rocbuilder/folding-trolley/20 design intent.txt

TO DESIGN A STORAGE SYSTEM, WHICH CAN BE COMPRESSED INTO A SMALLER SPACE WHEN NOT IN USE
