rocbuilder/folding-trolley/05 product specification.docx

Product specification

Characteristics:

Size reduction

Shelving that can be height adjusted

Lockable caster wheels for mobility

Specifications:

size (height, depth, length):

when expanded 165x60x120cm

when compressed 165x36x120cm

~40% size reduction
