rocbuilder/folding-trolley/01 product leaflet.pptx

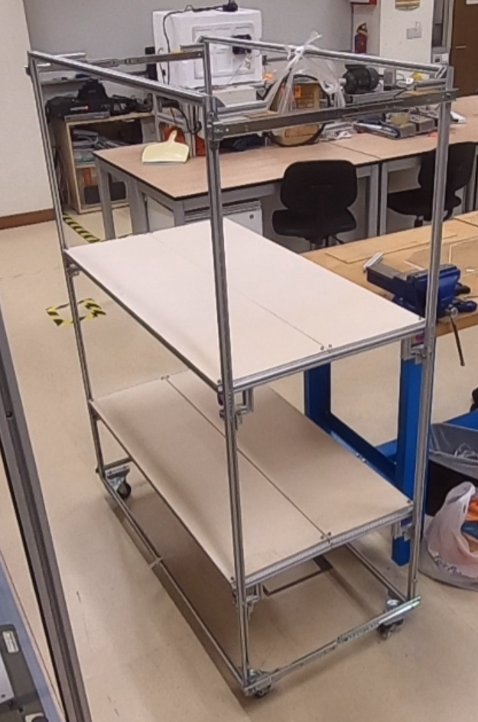
[picture p1: figure]
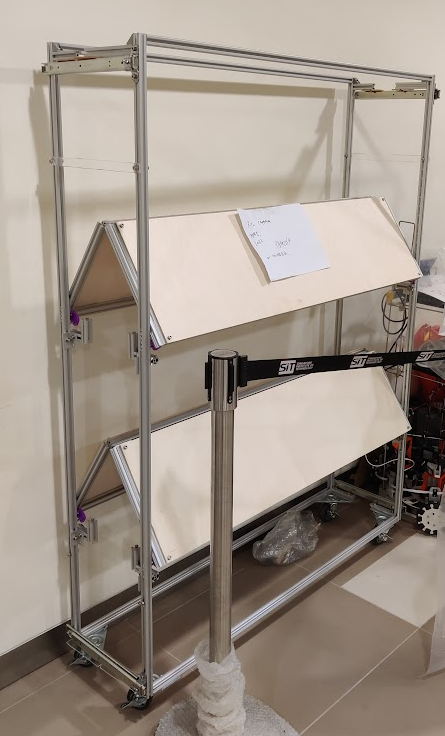
[picture p2: figure]

The collapsible cart

Features:
- Able to become 40% smaller
- On caster wheels
- Adjustable shelf heights
