rocbuilder/folding-trolley/03 presentation.pptx

## Design of a compressible shelving unit

Chew En Yu, 1901438

## Introduction

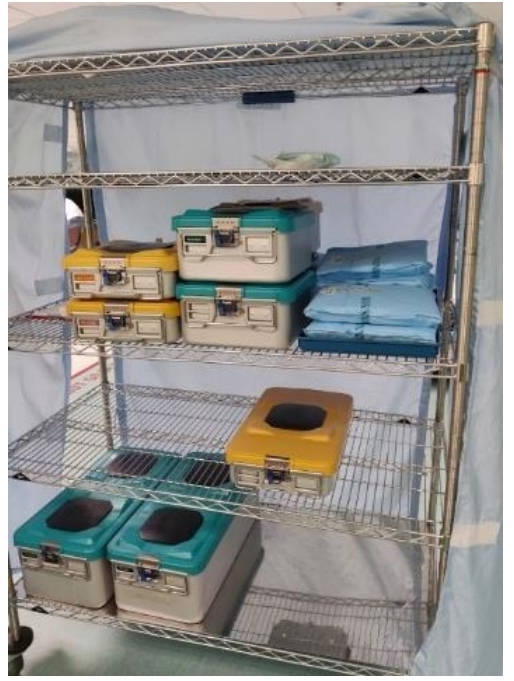
[picture p3: figure]

## Applicable products and mechanisms

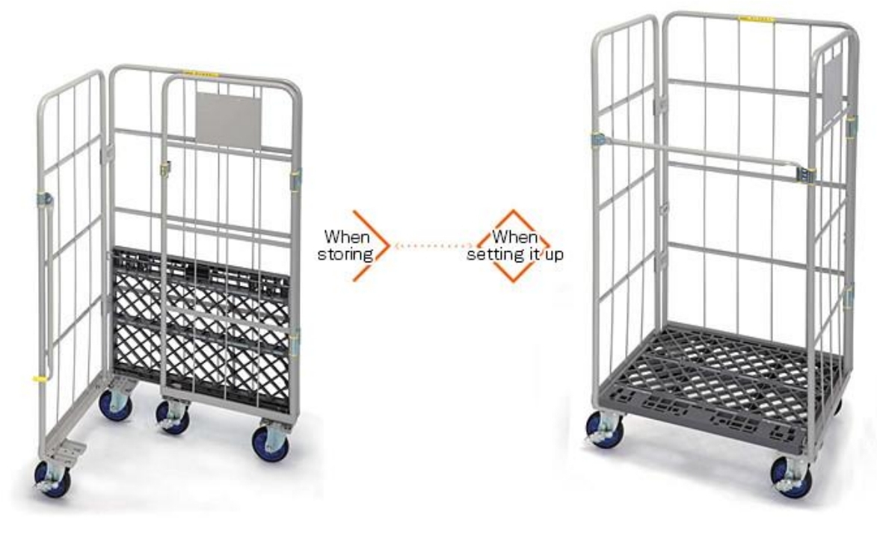
[picture p4: figure]
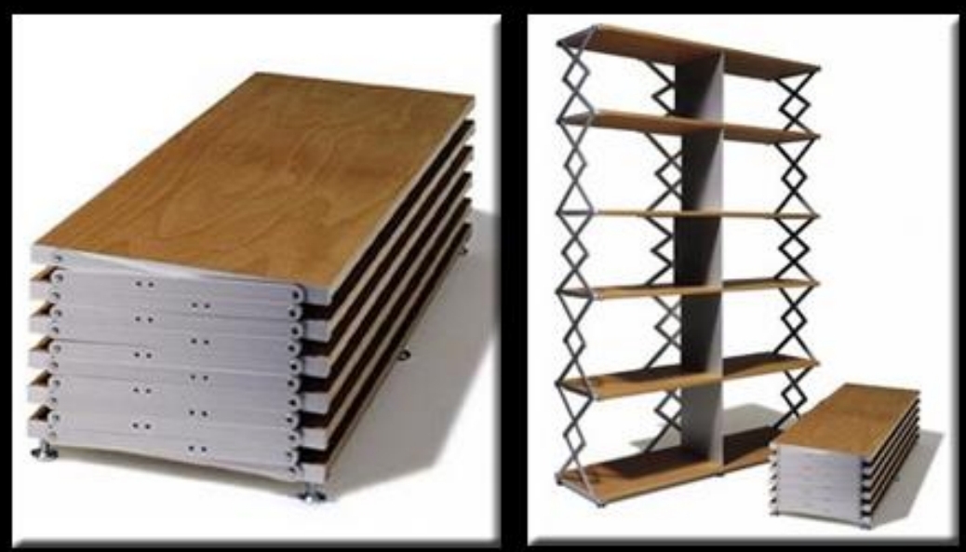
[picture p5: figure]

## Slide 4

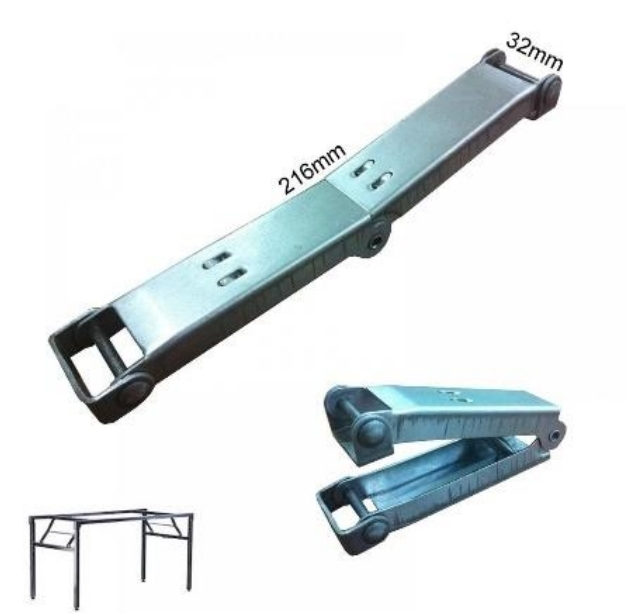
[picture p6: figure]
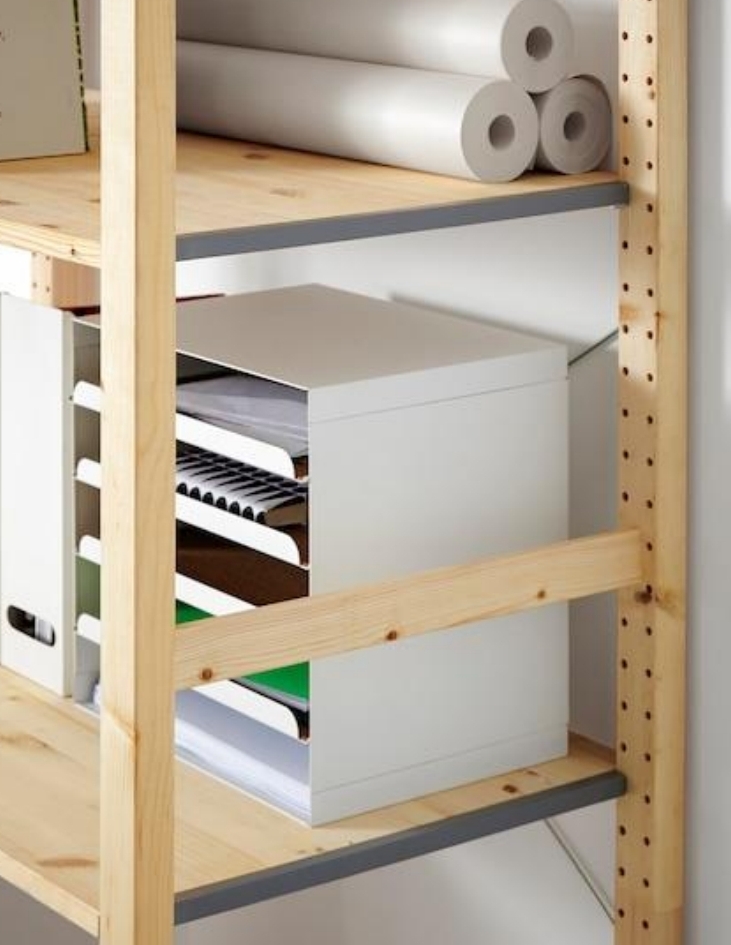
[picture p7: figure]
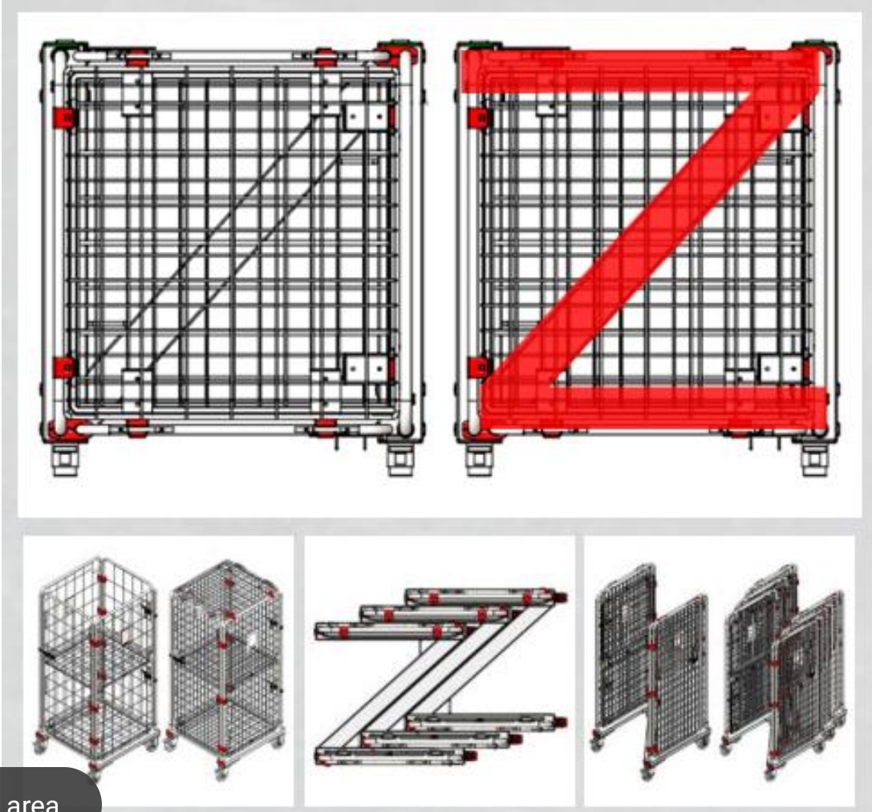
[picture p8: figure]

## Inspiration

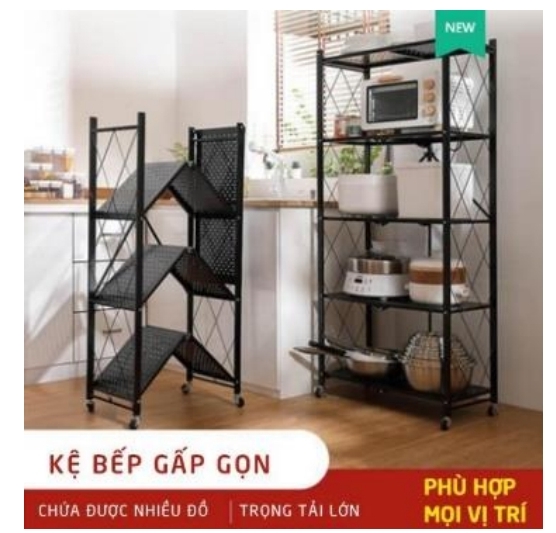
[picture p9: figure]

## Slide 6

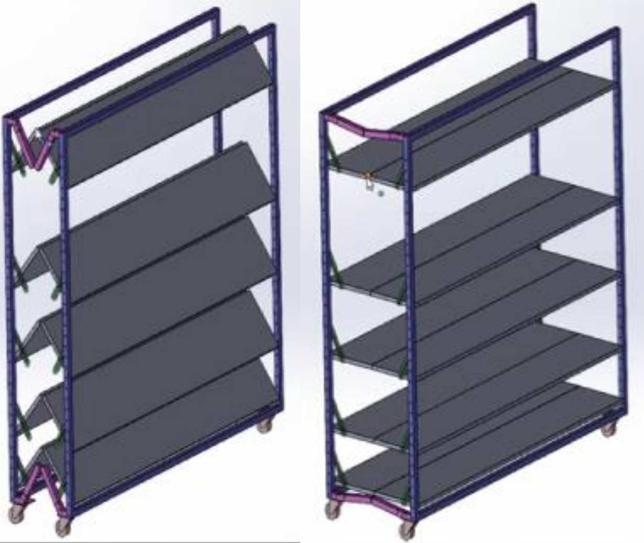
[picture p10: figure]
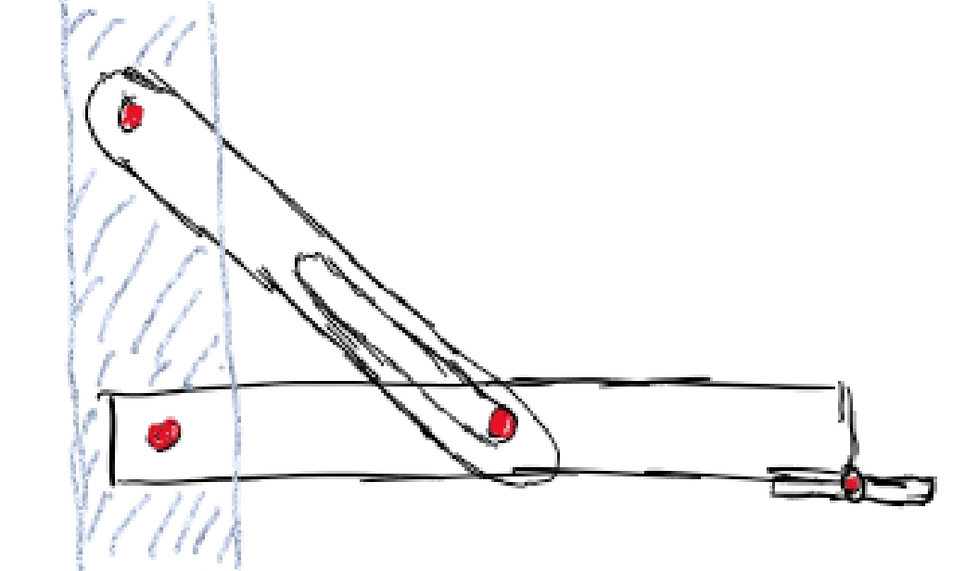
[picture p11: figure]

## Slide 7

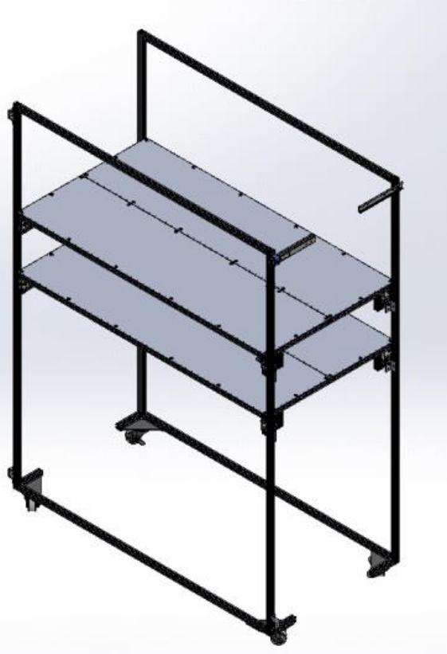
[picture p12: figure]
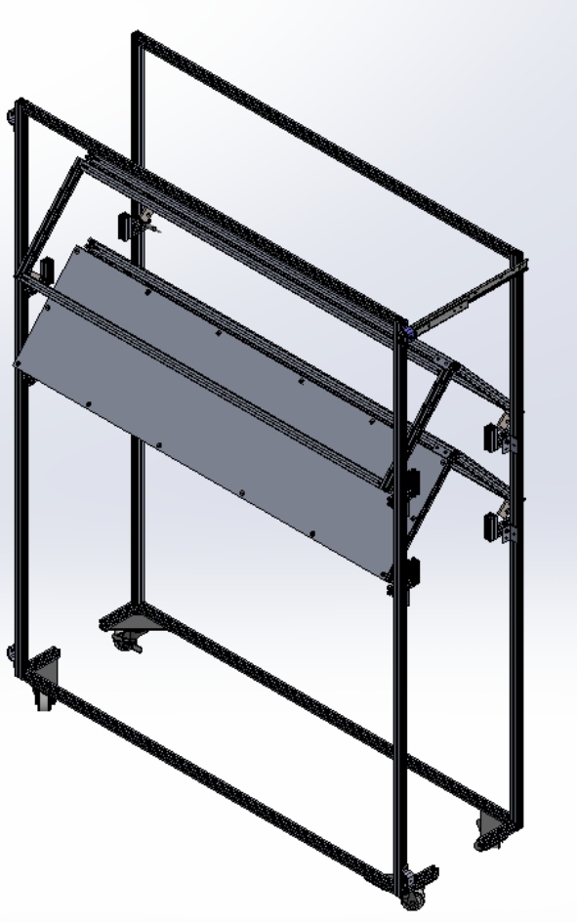
[picture p13: figure]

## Key features

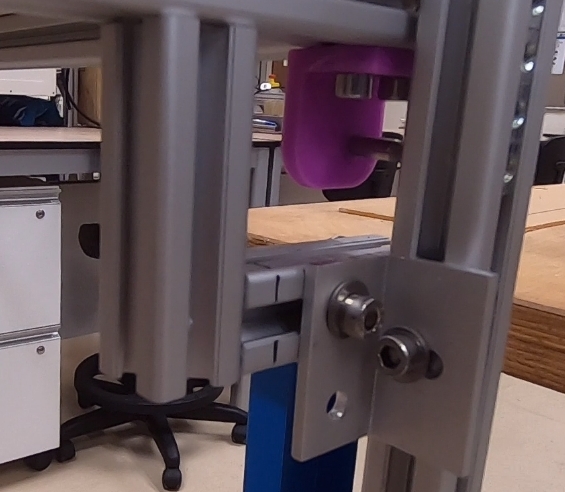
[picture p14: figure]
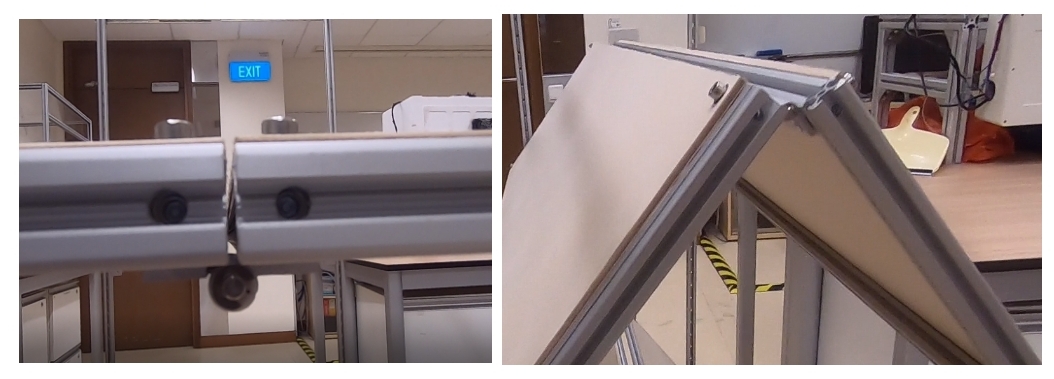
[picture p15: figure]

## Slide 9

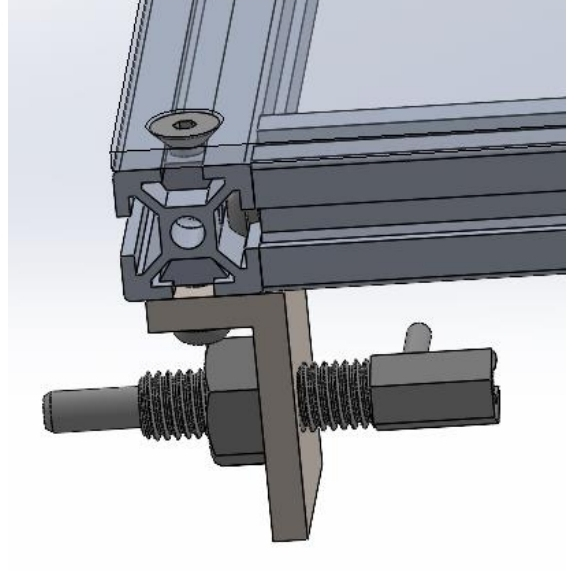
[picture p16: figure]
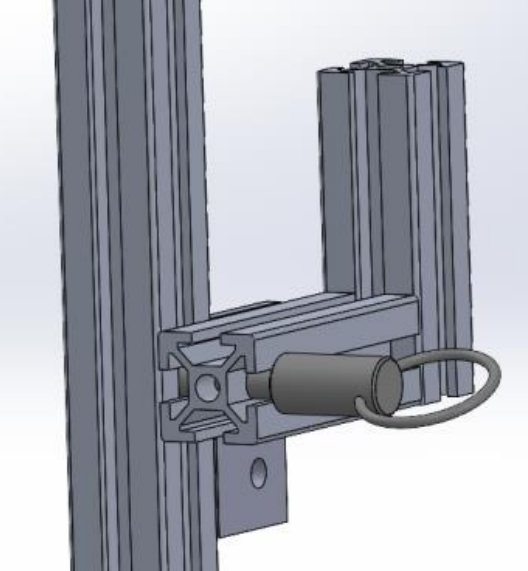
[picture p17: figure]

## Conclusion
