rocbuilder/folding-trolley/16 parts bom.xlsx

Sheet: detailed bom
ITEM NO. | PART NUMBER | DESCRIPTION | QTY. | supplier | supplier part number
1 | Shelf assembly adjustable |  | 2
1.1 | shelf length | 2020 profile, 1118mm, M5x16 tapped on both ends | 2 | prestech | PTP-2020-6
1.2 | shelf depth | 2020 profile, 300mm, wrench holes on both ends | 2 | prestech | PTP-2020-6
1.3 | HHPBSN5 flat 2020 hinge | aluminium 2020 profile hinge | 1 | prestech | PTA-AH2020-6
1.4 | HNTTSN5-5 2020 nut | 2020 profile nut | 22 | prestech | PTC-SBM5/2020
1.5 | SHFBS5-8 | hex socket CS flat head cap screw M5x8 | 18 | prestech | PTC-CS5X 8
1.6 | shelf top | 1158mm x 300mm plate with drilled holes | 1 | plywood online
1.7 | shelf angle bracket right | aluminium bracket | 1 | prestech | PTP-MB2038-5
1.8 | shelf angle bracket left | aluminium bracket | 1 | prestech | PTP-MB2038-5
1.9 | HBCBM5-15 | Hex socket button head cap screw M5x15 | 4 | prestech | PTC-SSBH5X 16
1.10 | lblt6 |  | 2
1.11 | SLBNR10 | M10 nut | 2
1.12 | SBCB5-10 | hex button head cap screw M5x10 | 4 | prestech | PTC-SSBH5X 10
1.13 | SPWF5 | M5 washer | 4
2 | shelf support left |  | 4
2.1 | HBCBM5-15 | Hex socket button head cap screw M5x15 | 1 | prestech | PTC-SSBH5X 16
2.2 | shelf support depth | 2020 profile | 1
2.3 | shelf support height | 2020 profile | 1
2.4 | shelf support bracket | L profile | 1 | prestech | PTP-2525AB-T3
2.5 | HNTTSN5-5 2020 nut | 2020 profile nut | 1 | prestech | PTC-SBM5/2020
2.6 | SCB5-8 | socket head cap screw M5x8 | 1 | prestech | PTC-SSSH5X 8
2.7 | SPWF5 | M5 washer | 1
3 | shelf support right |  | 4
3.1 | HBCBM5-15 | Hex socket button head cap screw M5x15 | 1 | prestech | PTC-SSBH5X 16
3.2 | shelf support depth | 2020 profile | 1
3.3 | shelf support height | 2020 profile | 1
3.4 | shelf support bracket | L profile | 1 | prestech | PTP-2525AB-T3
3.5 | HNTTSN5-5 2020 nut | 2020 profile nut | 1 | prestech | PTC-SBM5/2020
3.6 | SCB5-8 | socket head cap screw M5x8 | 1 | prestech | PTC-SSSH5X 8
3.7 | SPWF5 | M5 washer | 1
4 | SPWF5 | M5 washer | 6
5 | HNTTSN5-5 2020 nut | 2020 profile nut | 6 | prestech | PTC-SBM5/2020
6 | BLPS6-30 |  | 2
7 | SCB5-40 | hex button head cap screw M5x40 | 6 | prestech | PTC-SSSH5X 40
8 | shelf assembly fixed |  | 2
8.1 | shelf length | 2020 profile, 1118mm, M5x16 tapped on both ends | 2 | prestech | PTP-2020-6
8.2 | shelf depth | 2020 profile, 300mm, wrench holes on both ends | 2 | prestech | PTP-2020-6
8.3 | HHPBSN5 flat 2020 hinge | aluminium 2020 profile hinge | 1 | prestech | PTA-AH2020-6
8.4 | HNTTSN5-5 2020 nut | 2020 profile nut | 22 | prestech | PTC-SBM5/2020
8.5 | SHFBS5-8 | hex socket CS flat head cap screw M5x8 | 18 | prestech | PTC-CS5X 8
8.6 | shelf top | 1158mm x 300mm plate with drilled holes | 1 | plywood online
8.7 | shelf angle bracket right fixed | aluminium bracket | 1 | prestech | PTP-MB2038-5
8.8 | shelf angle bracket left fixed | aluminium bracket | 1 | prestech | PTP-MB2038-5
8.9 | HBCBM5-15 | Hex socket button head cap screw M5x15 | 4 | prestech | PTC-SSBH5X 16
8.10 | SCB6-45 | socket head cap screw M6x45 | 2 | prestech | PTC-SSSH6X 45
8.11 | SPWF6 | M6 washer | 2
8.12 | SLBNR6 | M6 nut | 2 | prestech | PTC-HNM6
8.13 | SBCB5-10 | hex button head cap screw M5x10 | 4 | prestech | PTC-SSBH5X 10
8.14 | SPWF5 | M5 washer | 4
9 | shelf extension mechanism |  | 4
9.1 | HBCBM5-10 | Hex socket button head cap screw M5x10 | 2 | prestech | PTC-SSBH5X 10
9.2 | SPWF5 | M5 washer | 2
9.3 | IBNP4-8 | hex button head cap screw M4x8 | 1 | prestech | PTC-SSBH4X 8
9.4 | SPWF4 | M4 washer | 1
9.5 | SLBNR4 | M4 nut | 1 | prestech | PTC-HNM4
9.6 | FBL27D+200L (MIN) |  | 1 | Monotaro | FBL27D+300
9.6.1 | _FBL27D+200 Drawer rail | Drawer rail part, wrong part number | 1 |  | FBL27D+300
9.6.2 | _FBL27D+200 Retainer | Drawer rail part, wrong part number | 2 |  | FBL27D+300
9.6.3 | _FBL27D+200 Center Rail | Drawer rail part, wrong part number | 2 |  | FBL27D+300
9.7 | _FBL27D+200 Drawer rail | Drawer rail part, wrong part number | 1 |  | FBL27D+300
9.8 | convex bent sheet metal mounting plate | convex sheet metal | 1 | prestech | custom sheet metal part
10 | frame assembly main side |  | 1
10.1 | frame vertical | 2020 profile, 1550mm, wrench hole on bottom end through front and left side, wrench hole on top end on front side, 40x 6OD holes every 30mm from 120mm from bottom on front side | 2 | prestech | PTP-2020-6
10.2 | frame horizontal | 2020 profile, 1160mm, M5x16 tapped on both ends | 2 | prestech | PTP-2020-6
10.3 | frame caster bracket | 2020 profile, 100mm, M5x16 tapped on one end | 2 | prestech | PTP-2020-6
10.4 | HBCBM5-15 | Hex socket button head cap screw M5x15 | 6 | prestech | PTC-SSBH5X 16
10.5 | HSMCS50-N |  | 2 | Monotaro
10.5.1 | _DUMMY-HSMCS50-N | aluminium caster part | 1
10.5.2 | _SWIVEL-HSMCS50 | aluminium caster part | 1
10.5.3 | _BODY-HSMCS50 | aluminium caster part | 1
10.5.4 | _WHEEL-HSMCS50-N | aluminium caster part | 1
10.5.5 | _STOPPER-HSMCS50 | aluminium caster part | 1
10.6 | HNTTSN5-5 2020 nut | 2020 profile nut | 16 | prestech | PTC-SBM5/2020
10.7 | SPWF5 | M5 washer | 8
10.8 | SCB5-10 | socket head cap screw M5x10 | 8 | prestech | PTC-SSSH5X 10
11 | frame assembly slave side |  | 1
11.1 | frame vertical | 2020 profile, 1550mm, wrench hole on bottom end through front and left side, wrench hole on top end on front side, 40x 6OD holes every 30mm from 120mm from bottom on front side | 2 | prestech | PTP-2020-6
11.2 | frame horizontal | 2020 profile, 1160mm, M5x16 tapped on both ends | 2 | prestech | PTP-2020-6
11.3 | frame caster bracket | 2020 profile, 100mm, M5x16 tapped on one end | 2 | prestech | PTP-2020-6
11.4 | HBCBM5-15 | Hex socket button head cap screw M5x15 | 6 | prestech | PTC-SSBH5X 16
11.5 | HSMCS50-N |  | 2 | Monotaro
11.5.1 | _DUMMY-HSMCS50-N | aluminium caster part | 1
11.5.2 | _SWIVEL-HSMCS50 | aluminium caster part | 1
11.5.3 | _BODY-HSMCS50 | aluminium caster part | 1
11.5.4 | _WHEEL-HSMCS50-N | aluminium caster part | 1
11.5.5 | _STOPPER-HSMCS50 | aluminium caster part | 1
11.6 | HNTTSN5-5 2020 nut | 2020 profile nut | 12 | prestech | PTC-SBM5/2020
11.7 | SPWF5 | M5 washer | 8
11.8 | SCB5-10 | socket head cap screw M5x10 | 8 | prestech | PTC-SSSH5X 10

Sheet: parts bom
ITEM NO. | PART NUMBER | DESCRIPTION | supplier | supplier part number | QTY. | ITEM NO. in detailed BOM
1 | frame vertical | 2020 profile, 1550mm, wrench hole on bottom end through front and left side, wrench hole on top end on front side, 40x 6OD holes every 30mm from 120mm from bottom on front side | prestech | PTP-2020-6 | 4 |  |  |  |  | 10.1 |  | 11.1
2 | frame horizontal | 2020 profile, 1160mm, M5x16 tapped on both ends | prestech | PTP-2020-6 | 4 |  |  |  |  | 10.2 |  | 11.2
3 | frame caster bracket | 2020 profile, 100mm, M5x16 tapped on one end | prestech | PTP-2020-6 | 4 |  |  |  |  | 10.3 |  | 11.3
4 | HBCBM5-15 | Hex socket button head cap screw M5x15 | prestech | PTC-SSBH5X 16 | 36 | 1.9 |  | 3.1 | 8.9 | 10.4 |  | 11.4
5 | _DUMMY-HSMCS50-N | aluminium caster part | misumi |  | 4 |  |  |  |  |  |  | 11.5.1
6 | _SWIVEL-HSMCS50 | aluminium caster part | misumi |  | 4 |  |  |  |  |  |  | 11.5.2
7 | _BODY-HSMCS50 | aluminium caster part | misumi |  | 4 |  |  |  |  |  |  | 11.5.3
8 | _WHEEL-HSMCS50-N | aluminium caster part | misumi |  | 4 |  |  |  |  |  |  | 11.5.4
9 | _STOPPER-HSMCS50 | aluminium caster part | misumi |  | 4 |  |  |  |  |  |  | 11.5.5
10 | HNTTSN5-5 2020 nut | 2020 profile nut | prestech | PTC-SBM5/2020 | 130 | 1.4 |  | 3.5 | 8.4 |  | 10.6 | 11.6 | 5
11 | SPWF5 | M5 washer |  |  | 54 | 1.13 |  | 3.7 | 8.14 | 9.2 | 10.7 | 11.7 | 4
12 | SCB5-10 | socket head cap screw M5x10 | prestech | PTC-SSBH5X 10 | 16 |  |  |  |  |  | 10.8 | 11.8
13 | shelf length | 2020 profile, 1118mm, M5x16 tapped on both ends | prestech | PTP-2020-6 | 8 | 1.1 |  |  | 8.1
14 | shelf depth | 2020 profile, 300mm, wrench holes on both ends | prestech | PTP-2020-6 | 8 | 1.2 |  |  | 8.2
15 | HHPBSN5 flat 2020 hinge | aluminium 2020 profile hinge | prestech | PTA-AH2020-6 | 4 | 1.3 |  |  | 8.3
16 | SHFBS5-8 | hex socket CS flat head cap screw M5x8 | prestech | PTC-CS5X 8 | 72 | 1.5 |  |  | 8.5
17 | shelf top | 1158mm x 300mm plate with drilled holes |  |  | 4 | 1.6 |  |  | 8.6
18 | shelf angle bracket right | aluminium bracket | prestech | PTP-MB2038-5 | 2 | 1.7
19 | shelf angle bracket left | aluminium bracket | prestech | PTP-MB2038-5 | 2 | 1.8
20 | lblt6 |  |  |  | 4 | 1.1
21 | SLBNR10 | M10 nut |  |  | 4 | 1.11
22 | SCB6-45 | socket head cap screw M6x45 | prestech | PTC-SSBH6X 45 | 4 |  |  |  | 8.1
23 | SPWF6 | M6 washer |  |  | 4 |  |  |  | 8.11
24 | SLBNR6 | M6 nut | prestech | PTC-HNM6 | 4 |  |  |  | 8.12
25 | SBCB5-10 | hex button head cap screw M5x10 | prestech | PTC-SSBH5X 10 | 16 | 1.12 |  |  | 8.13
26 | shelf support depth | 2020 profile | prestech |  | 8 |  | 2.2 | 3.2
27 | shelf support height | shelf support height | prestech |  | 8 |  | 2.3 | 3.3
28 | shelf support bracket | L profile | prestech | PTP-2525AB-T3 | 8 |  | 2.4 | 3.4
29 | SCB5-8 | socket head cap screw M5x8 | prestech | PTC-SSBH5X 8 | 8 |  | 2.6 | 3.6
30 | convex bent sheet metal mounting plate | convex sheet metal | prestech | custom sheet metal part | 4 |  |  |  |  | 9.8
31 | HBCBM5-10 | Hex socket button head cap screw M5x10 | prestech | PTC-SSBH5X 10 | 8 |  |  |  |  | 9.1
32 | IBNP4-8 | hex button head cap screw M4x8 | prestech | PTC-SSBH4X 8 | 4 |  |  |  |  | 9.3
33 | SPWF4 | M4 washer |  |  | 4 |  |  |  |  | 9.4
34 | SLBNR4 | M4 nut | prestech | PTC-HNM4 | 4 |  |  |  |  | 9.5
35 | _FBL27D+200 Drawer rail | Drawer rail part, wrong part number | misumi | FBL27D+300 | 8 |  |  |  |  | 9.7 | 9.6.1
36 | BLPS6-30 |  |  |  | 2 |  |  |  |  |  |  |  | 6
37 | SCB5-40 | hex button head cap screw M5x40 | KL lane |  | 6 |  |  |  |  |  |  |  | 7
38 | shelf angle bracket right fixed | aluminium bracket | prestech | PTP-MB2038-5 | 2 |  |  |  | 8.7
39 | shelf angle bracket left fixed | aluminium bracket | prestech | PTP-MB2038-5 | 2 |  |  |  | 8.8
40 | _FBL27D+200 Retainer | Drawer rail part, wrong part number | misumi | FBL27D+300 | 8 |  |  |  |  |  | 9.6.2
41 | _FBL27D+200 Center Rail | Drawer rail part, wrong part number | misumi | FBL27D+300 | 8 |  |  |  |  |  | 9.6.3

Sheet: price summary
supplier | Parts | cost (SGD) | remarks | contact
prestech | aluminium profile and profile system | 500.55 | quotation basis | email to sales@prestech.com.sg
plywood online | plywood shelf top | 25 | online purchase; supplier quotes $12.50 for sizes ~0.8m^2 and below. 2x plywood was purchased, then sawn in half to reduce cost | www.Plywood-Online.com
Monotaro | Slide rail FBL27D | 155.96 | online purchase | https://www.monotaro.sg
 | Corner caster SGC series | 47.96
 | total | 729.47
