rocbuilder/folding-trolley/12 original part assembly and drawing/shelf assembly.SLDASM

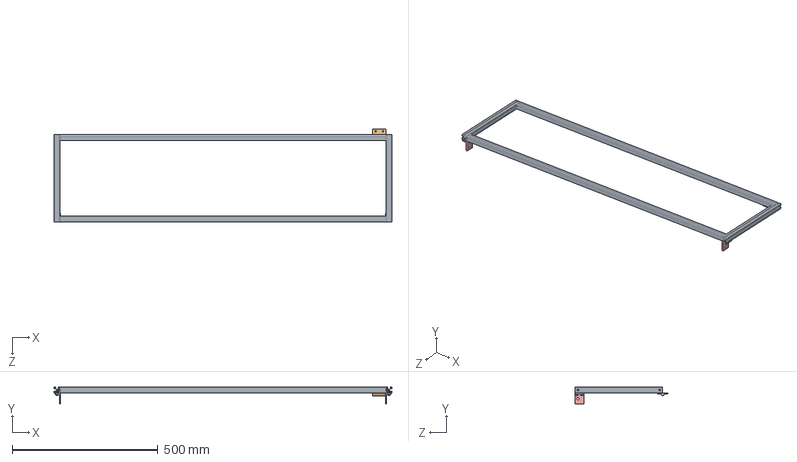
[picture p18: CAD file, 2022-11-20]
12 original part assembly and drawing/shelf assembly.SLDASM
1158.0 x 58.0 x 318.5 mm
HFS Aluminium Frame 2020 x 4
HHPBSN5 flat 2020 hinge
HNTTSN5-5 2020 nut x 8
SHFBS5-8 x 2
shelf mechanism angle bracket x 2
HBCBM5-15 x 4
SBCB5-10 x 4
SPWF5 x 4
