rocbuilder/folding-trolley/12 original part assembly and drawing/full assembly.SLDASM

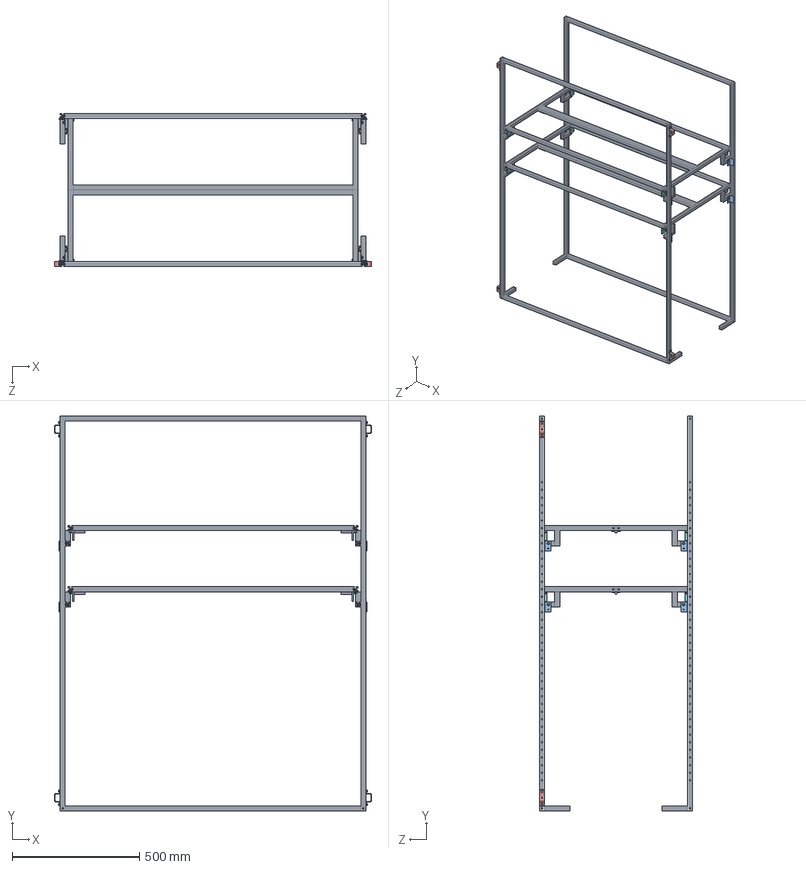
[picture p19: CAD file, 2022-11-20]
12 original part assembly and drawing/full assembly.SLDASM
1244.2 x 1550.0 x 601.0 mm
HFS Aluminium Frame 2020 x 44
HBCBM5-15 x 36
HNTTSN5-5 2020 nut x 56
HBCBM5-10 x 8
convex bent sheet metal mounting plate x 4
HHPBSN5 flat 2020 hinge x 4
SHFBS5-8 x 8
shelf mechanism angle bracket x 8
SBCB5-10 x 16
SPWF5 x 24
shelf support bracket x 8
SCB5-8 x 8
