rocbuilder/folding-trolley/12 original part assembly and drawing/frame assembly.SLDASM

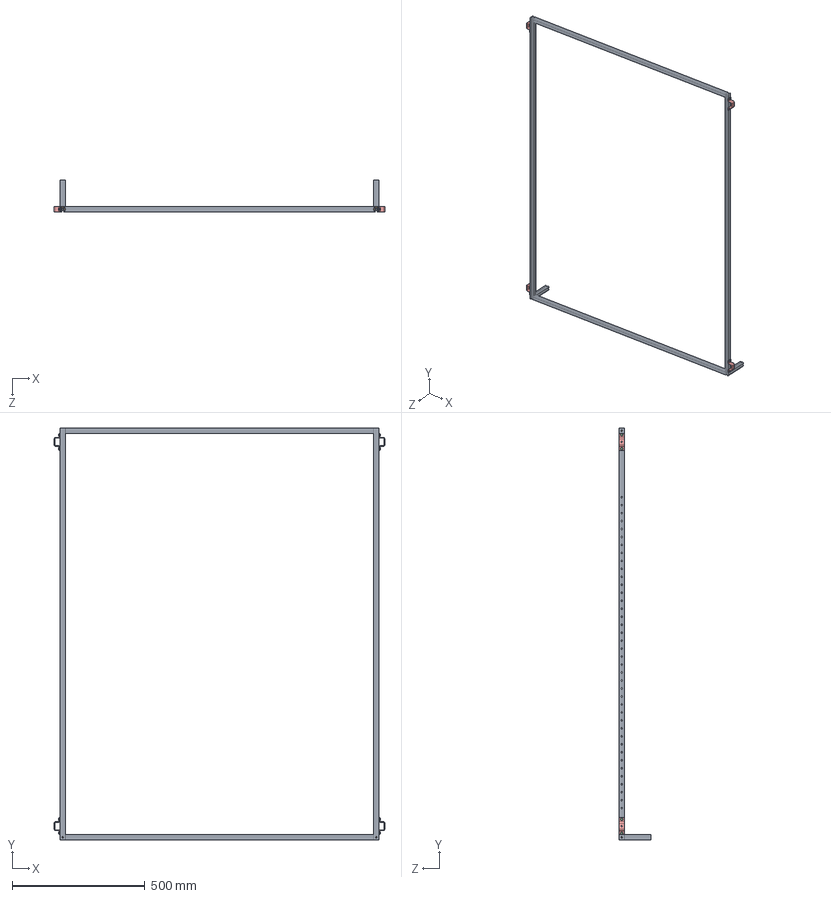
[picture p20: CAD file, 2022-11-20]
12 original part assembly and drawing/frame assembly.SLDASM
1244.2 x 1550.0 x 120.0 mm
HFS Aluminium Frame 2020 x 6
HBCBM5-15 x 6
HNTTSN5-5 2020 nut x 12
HBCBM5-10 x 8
convex bent sheet metal mounting plate x 4
