rocbuilder/folding-trolley/12 original part assembly and drawing/C-CTCS125-R.SLDASM

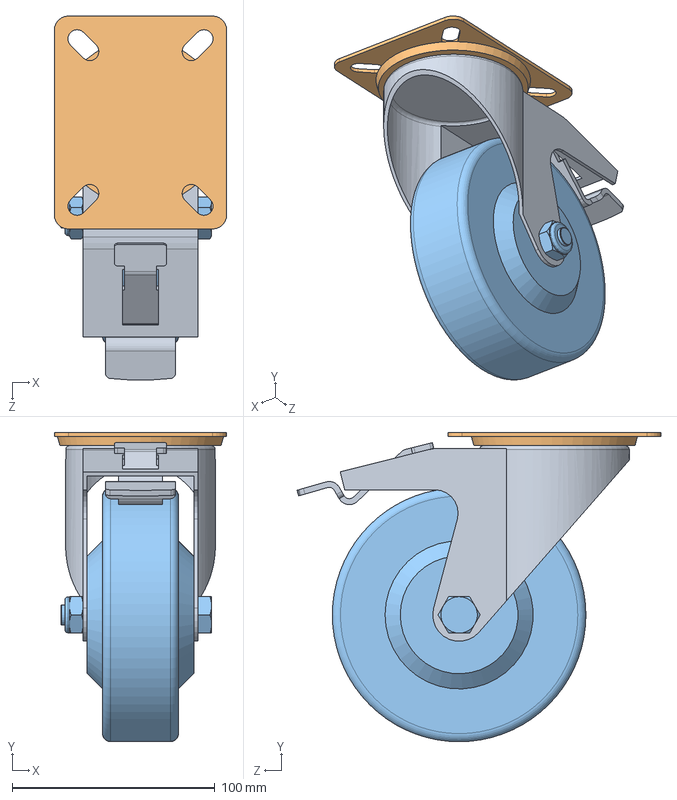
[picture p21: CAD file, 2022-11-20]
12 original part assembly and drawing/C-CTCS125-R.SLDASM
85.0 x 152.5 x 179.4 mm
_C-CTCS125-R_b
_C-CTCS125-R_m
_C-CTCS125-R_w
