rocbuilder/folding-trolley/12 original part assembly and drawing/HSMCS50-N.SLDASM

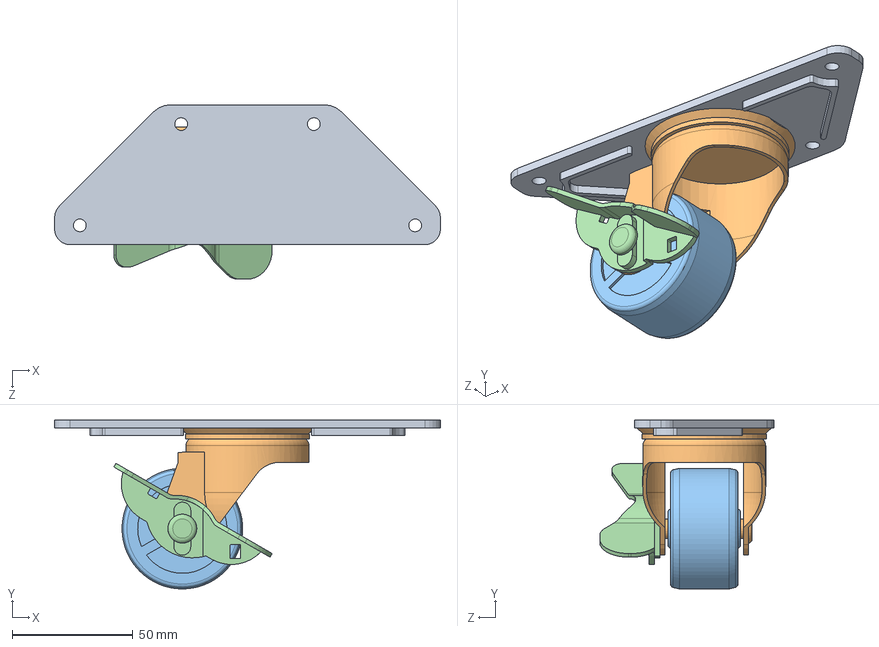
[picture p22: CAD file, 2022-11-20]
12 original part assembly and drawing/HSMCS50-N.SLDASM
160.0 x 70.0 x 72.3 mm
_SWIVEL-HSMCS50
_BODY-HSMCS50
_WHEEL-HSMCS50-N
_STOPPER-HSMCS50
