rocbuilder/folding-trolley/12 original part assembly and drawing/shelf support.SLDASM

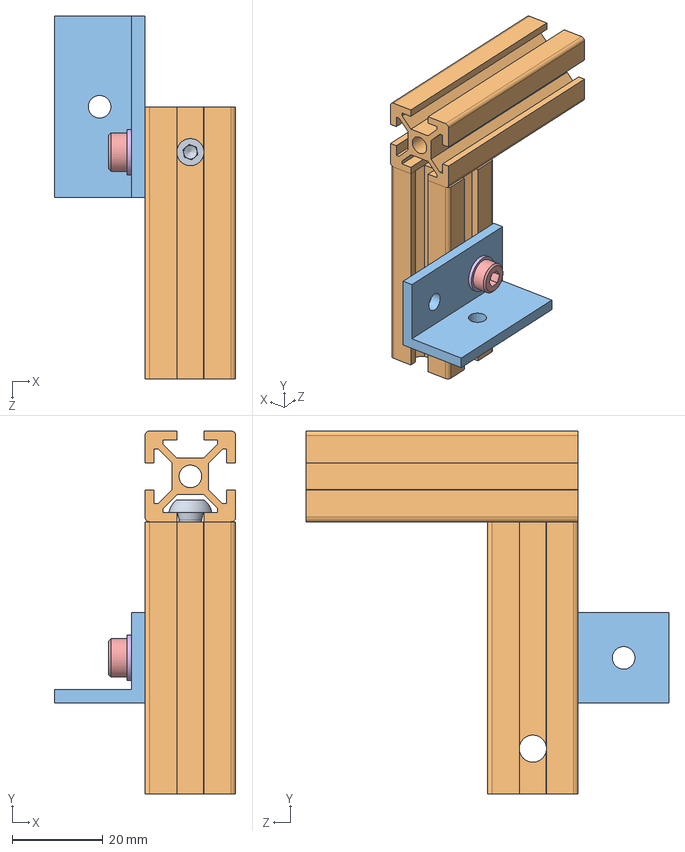
[picture p23: CAD file, 2022-11-20]
12 original part assembly and drawing/shelf support.SLDASM
40.0 x 80.0 x 80.0 mm
HBCBM5-15
HFS Aluminium Frame 2020 x 2
shelf support bracket
HNTTSN5-5 2020 nut
SCB5-8
SPWF5
