rocbuilder/folding-trolley/12 original part assembly and drawing/shelf extension mechanism.SLDASM

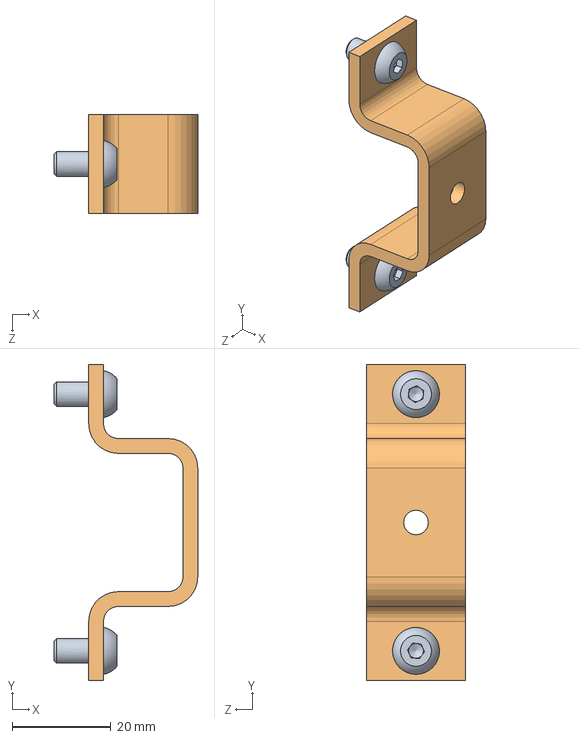
[picture p24: CAD file, 2022-11-20]
12 original part assembly and drawing/shelf extension mechanism.SLDASM
29.1 x 64.0 x 20.0 mm
HBCBM5-10 x 2
convex bent sheet metal mounting plate
