rocbuilder/folding-trolley/12 original part assembly and drawing/SLBNR10.SLDPRT

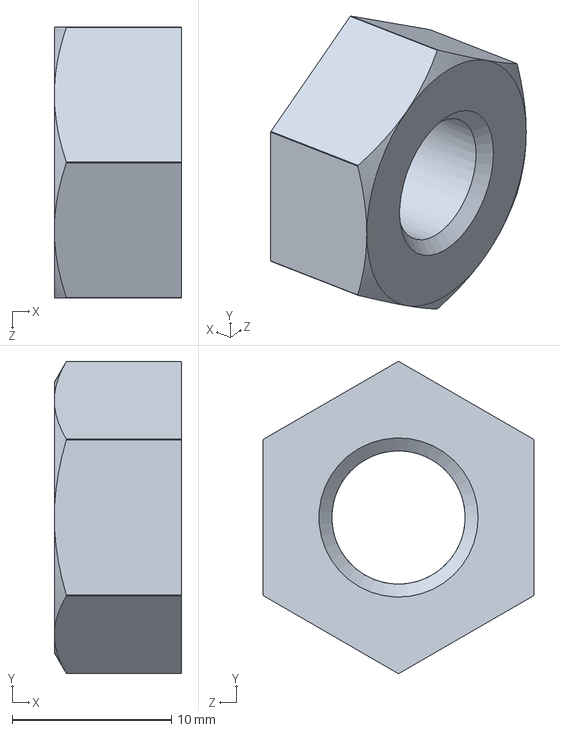
[picture p25: CAD file, 2022-11-20]
12 original part assembly and drawing/SLBNR10.SLDPRT
8.00 x 19.6 x 17.0 mm
