rocbuilder/folding-trolley/12 original part assembly and drawing/SHFBS5-8.SLDPRT

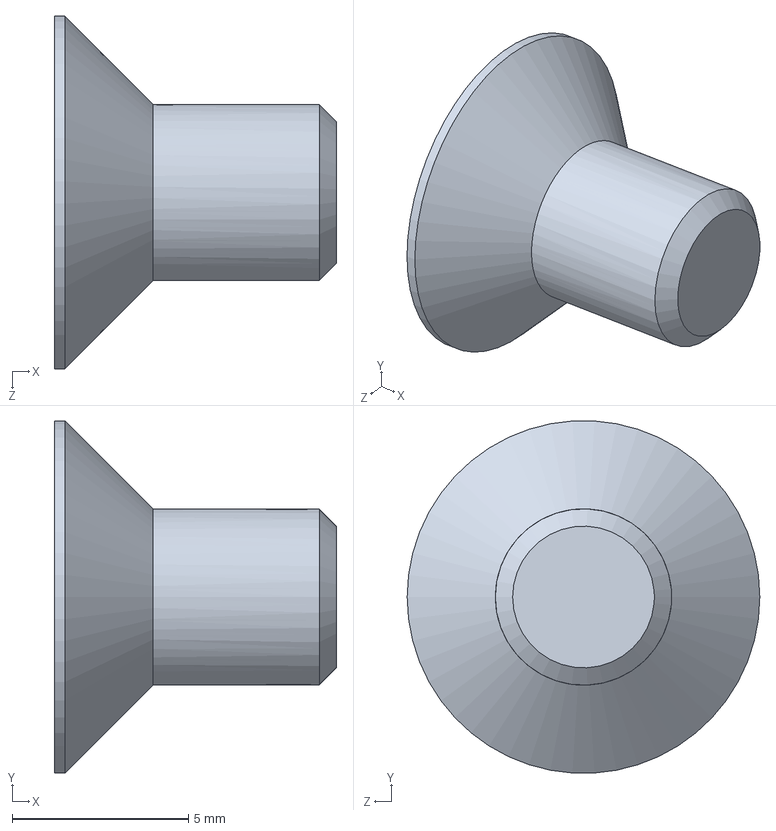
[picture p26: CAD file, 2022-11-20]
12 original part assembly and drawing/SHFBS5-8.SLDPRT
8.00 x 9.98 x 10.0 mm
