rocbuilder/folding-trolley/12 original part assembly and drawing/SPWF3.SLDPRT

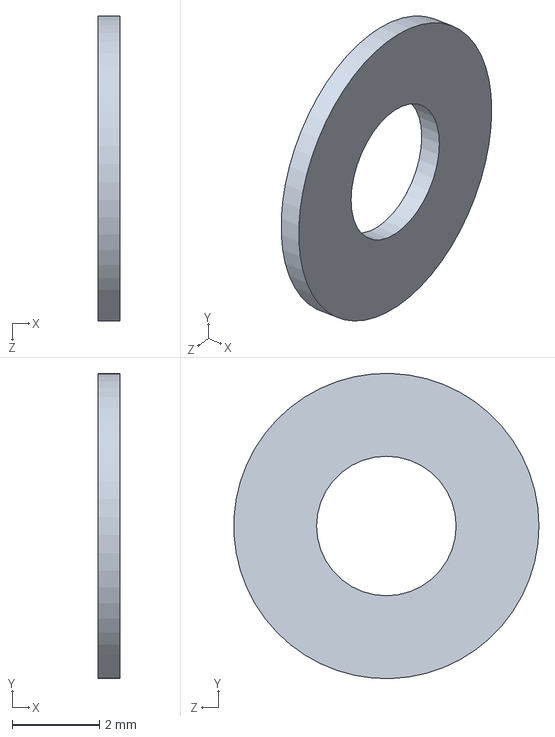
[picture p27: CAD file, 2022-11-20]
12 original part assembly and drawing/SPWF3.SLDPRT
0.5 x 7.00 x 6.99 mm
