rocbuilder/folding-trolley/12 original part assembly and drawing/HNTTSN6-3.SLDPRT

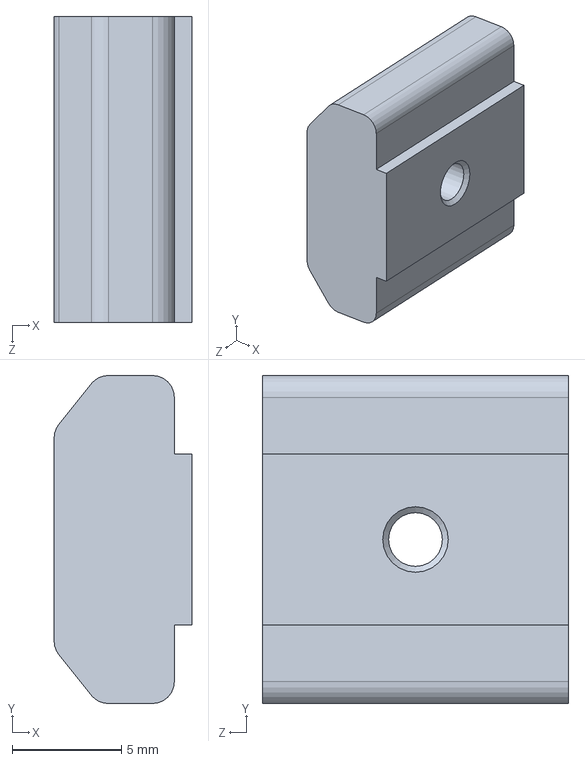
[picture p28: CAD file, 2022-11-20]
12 original part assembly and drawing/HNTTSN6-3.SLDPRT
6.30 x 15.0 x 14.0 mm
