rocbuilder/folding-trolley/12 original part assembly and drawing/SLBNR4.SLDPRT

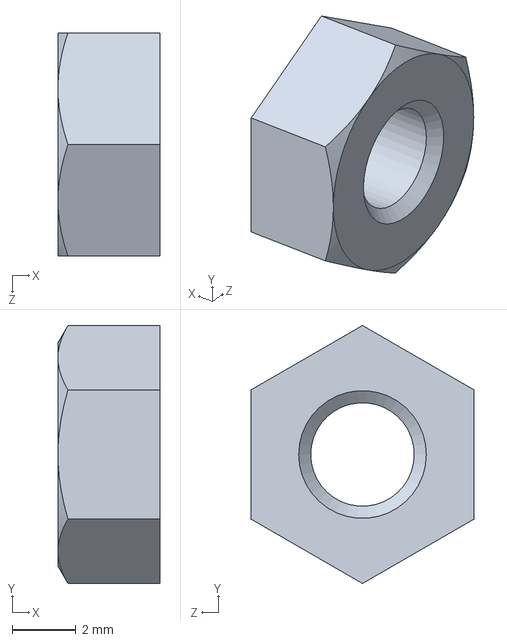
[picture p29: CAD file, 2022-11-20]
12 original part assembly and drawing/SLBNR4.SLDPRT
3.20 x 8.08 x 7.00 mm
