rocbuilder/folding-trolley/12 original part assembly and drawing/HBCBM5-15.SLDPRT

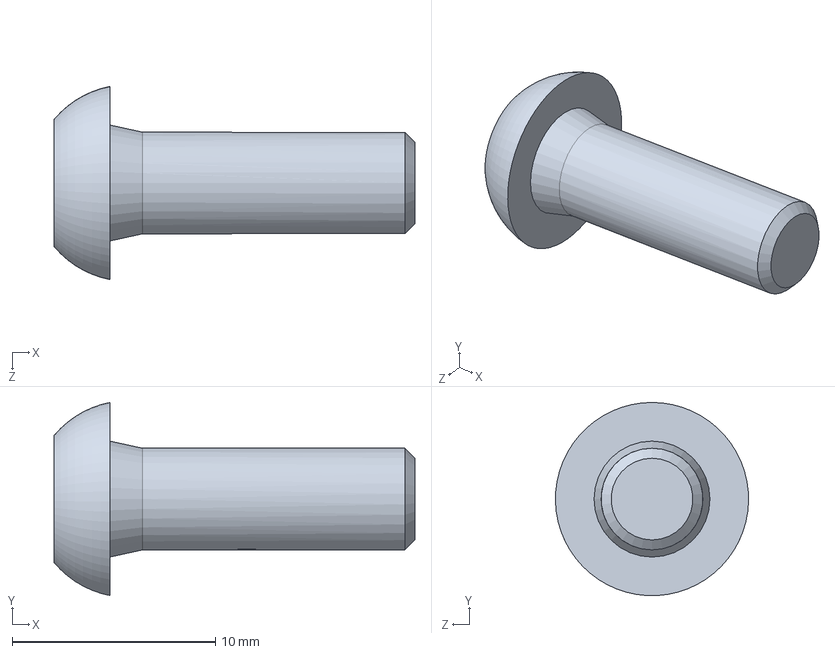
[picture p30: CAD file, 2022-11-20]
12 original part assembly and drawing/HBCBM5-15.SLDPRT
17.8 x 9.49 x 9.50 mm
