rocbuilder/folding-trolley/12 original part assembly and drawing/SCB6-45.SLDPRT

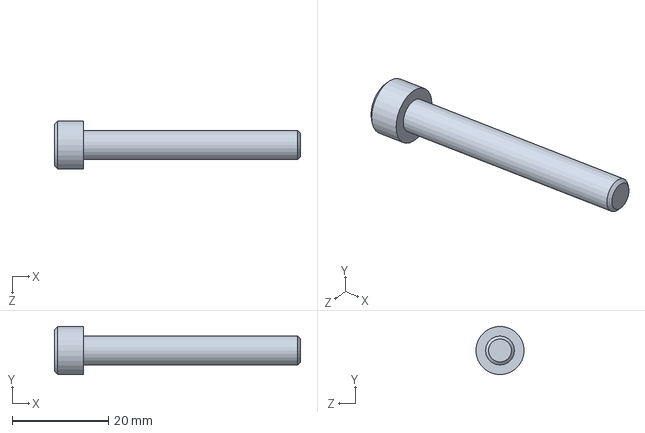
[picture p31: CAD file, 2022-11-20]
12 original part assembly and drawing/SCB6-45.SLDPRT
51.0 x 10.0 x 10.0 mm
