rocbuilder/folding-trolley/12 original part assembly and drawing/CBSST8-20.SLDPRT

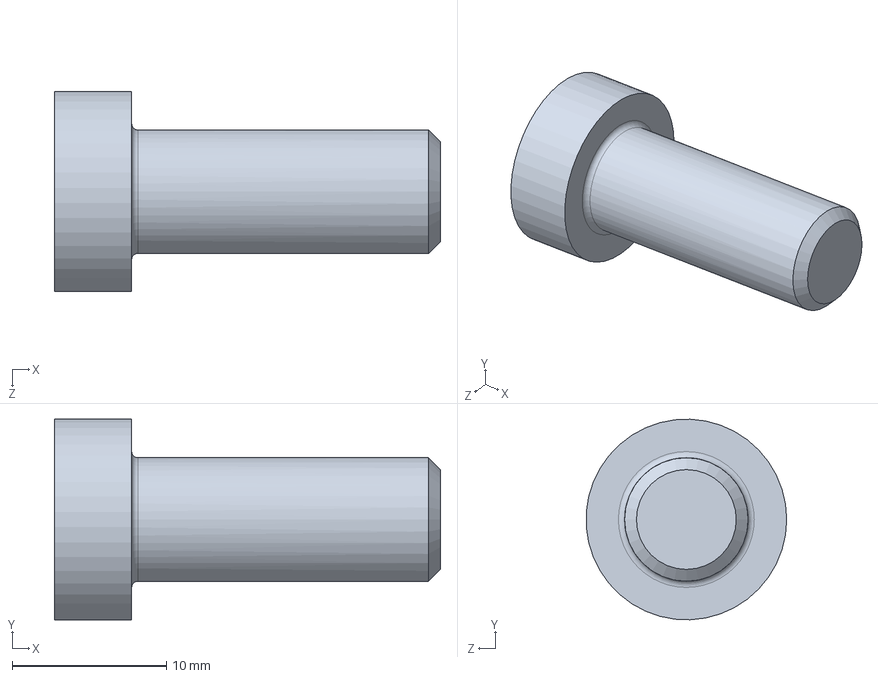
[picture p32: CAD file, 2022-11-20]
12 original part assembly and drawing/CBSST8-20.SLDPRT
25.0 x 13.0 x 13.0 mm
