rocbuilder/folding-trolley/12 original part assembly and drawing/BLPS10-60.SLDPRT

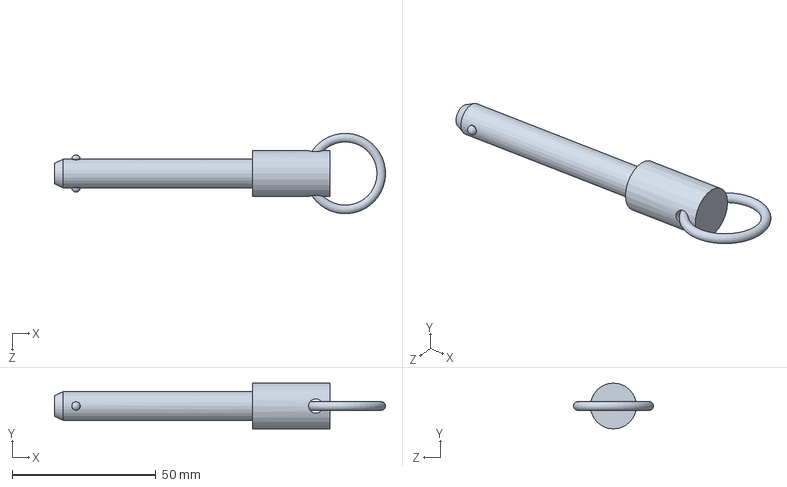
[picture p33: CAD file, 2022-11-20]
12 original part assembly and drawing/BLPS10-60.SLDPRT
115.3 x 16.0 x 28.0 mm
