rocbuilder/folding-trolley/12 original part assembly and drawing/SLBNR6.SLDPRT

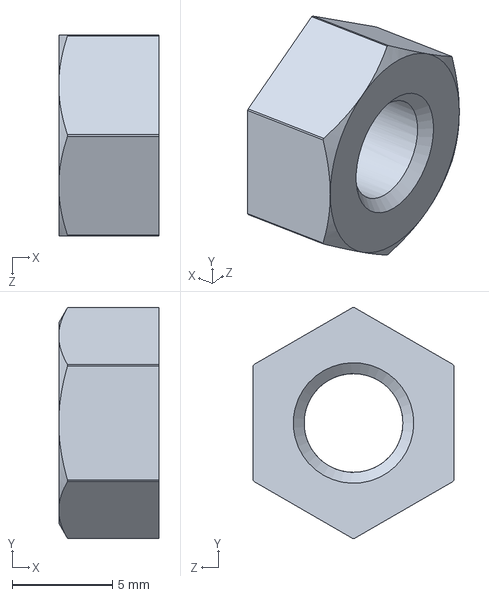
[picture p34: CAD file, 2022-11-20]
12 original part assembly and drawing/SLBNR6.SLDPRT
5.00 x 11.5 x 10.0 mm
