rocbuilder/folding-trolley/12 original part assembly and drawing/shelf mechanism angle bracket.SLDPRT

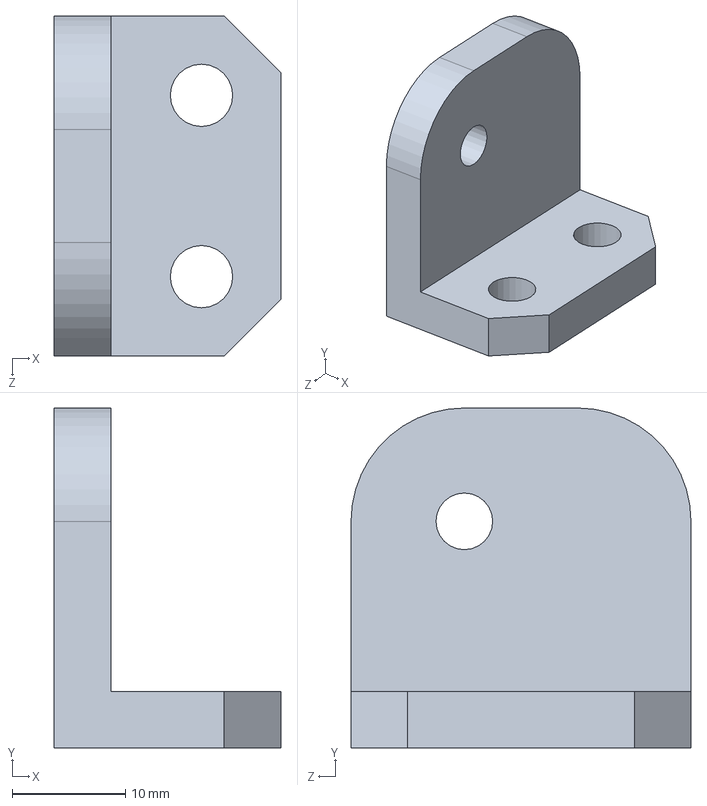
[picture p35: CAD file, 2022-11-20]
12 original part assembly and drawing/shelf mechanism angle bracket.SLDPRT
20.0 x 30.0 x 30.0 mm
