rocbuilder/folding-trolley/12 original part assembly and drawing/BCS-08-18 standin.SLDPRT

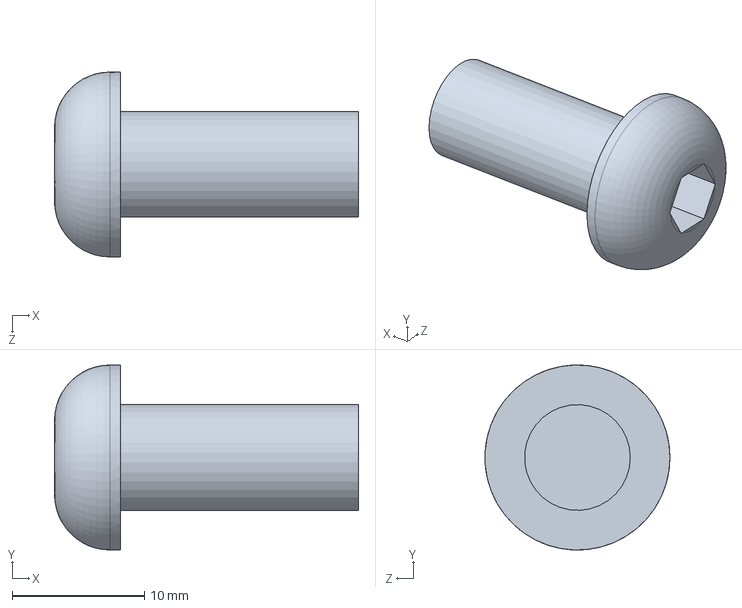
[picture p36: CAD file, 2022-11-20]
12 original part assembly and drawing/BCS-08-18 standin.SLDPRT
23.0 x 14.0 x 14.0 mm
