rocbuilder/folding-trolley/12 original part assembly and drawing/SPWF4.SLDPRT

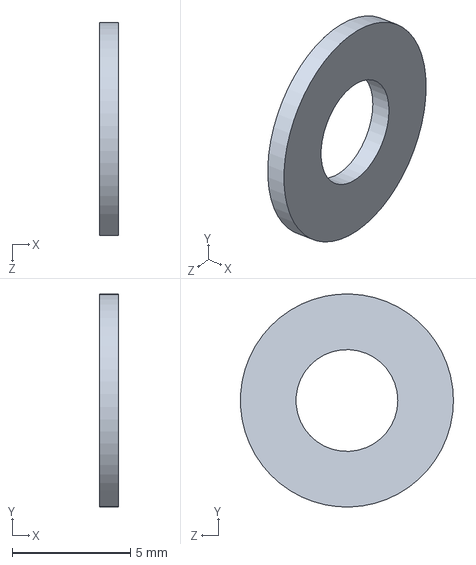
[picture p37: CAD file, 2022-11-20]
12 original part assembly and drawing/SPWF4.SLDPRT
0.8 x 9.00 x 8.99 mm
