rocbuilder/folding-trolley/12 original part assembly and drawing/_HBLFSNE6_.SLDPRT

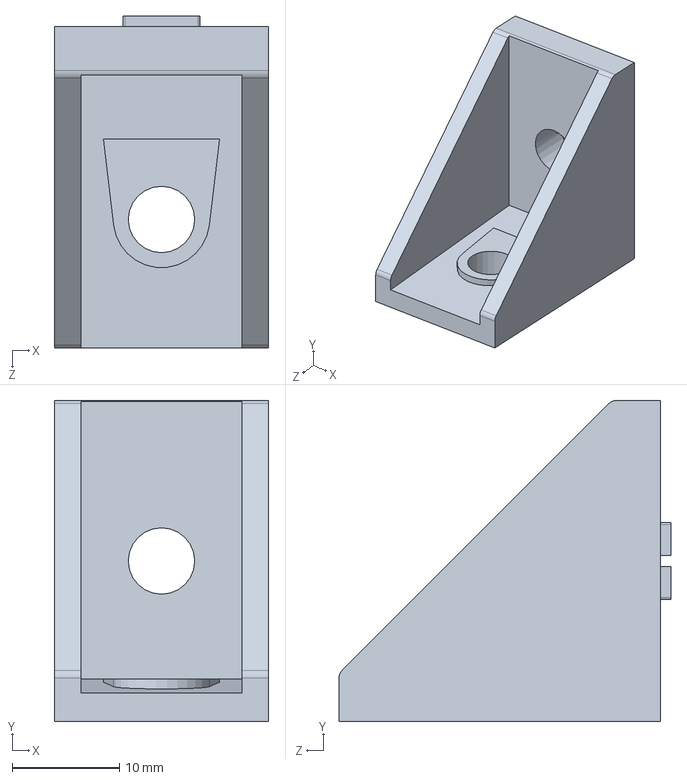
[picture p38: CAD file, 2022-11-20]
12 original part assembly and drawing/_HBLFSNE6_.SLDPRT
20.0 x 30.0 x 31.0 mm
