rocbuilder/folding-trolley/12 original part assembly and drawing/HFS Aluminium Frame 2020.SLDPRT

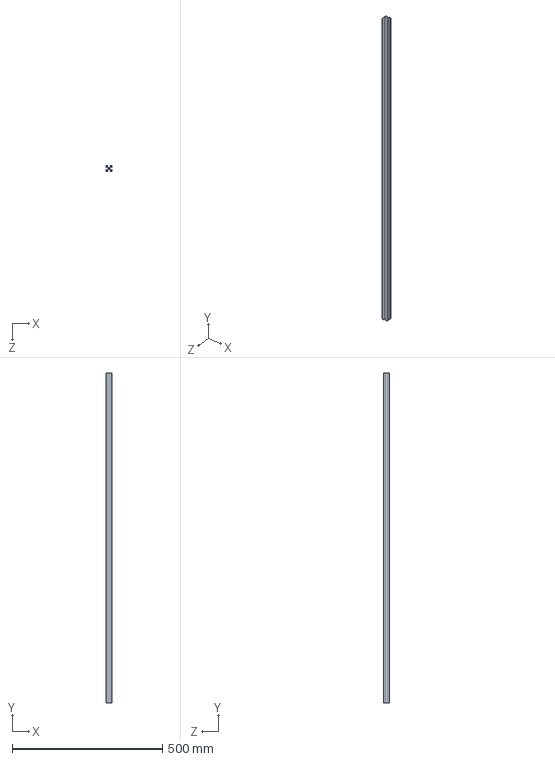
[picture p39: CAD file, 2022-11-20]
12 original part assembly and drawing/HFS Aluminium Frame 2020.SLDPRT
20.0 x 1098.0 x 20.0 mm
