rocbuilder/folding-trolley/12 original part assembly and drawing/SCB3-12.SLDPRT

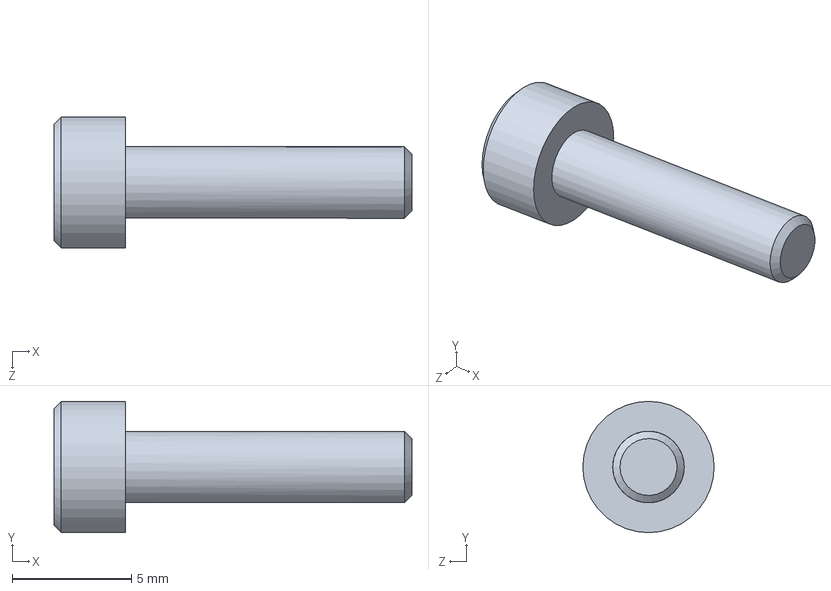
[picture p40: CAD file, 2022-11-20]
12 original part assembly and drawing/SCB3-12.SLDPRT
15.0 x 5.50 x 5.50 mm
