rocbuilder/folding-trolley/12 original part assembly and drawing/SCB5-8.SLDPRT

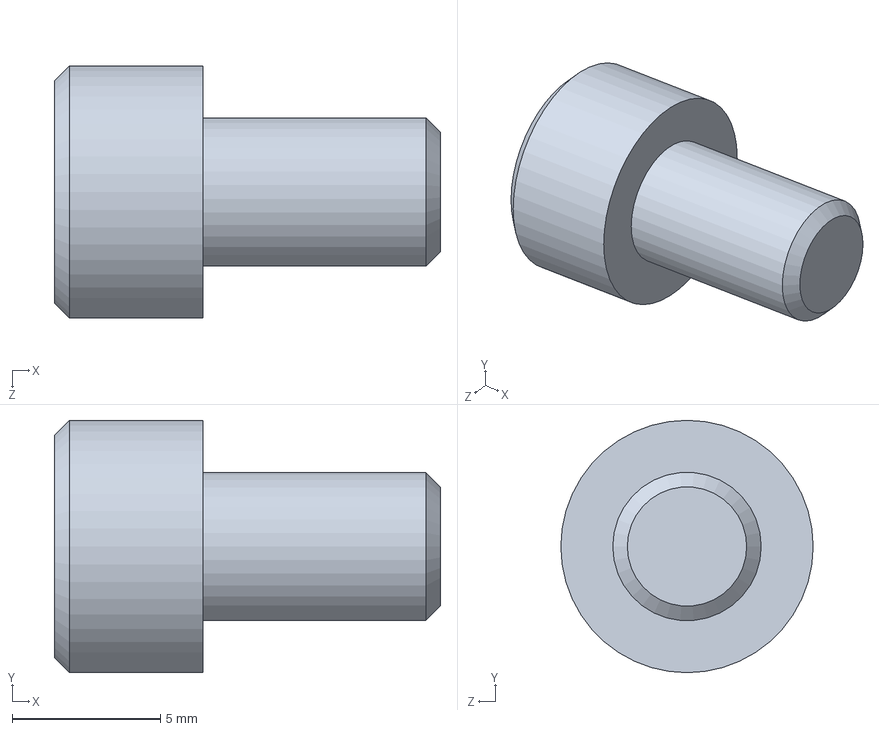
[picture p41: CAD file, 2022-11-20]
12 original part assembly and drawing/SCB5-8.SLDPRT
13.0 x 8.50 x 8.50 mm
