rocbuilder/folding-trolley/12 original part assembly and drawing/HBCBM5-10.SLDPRT

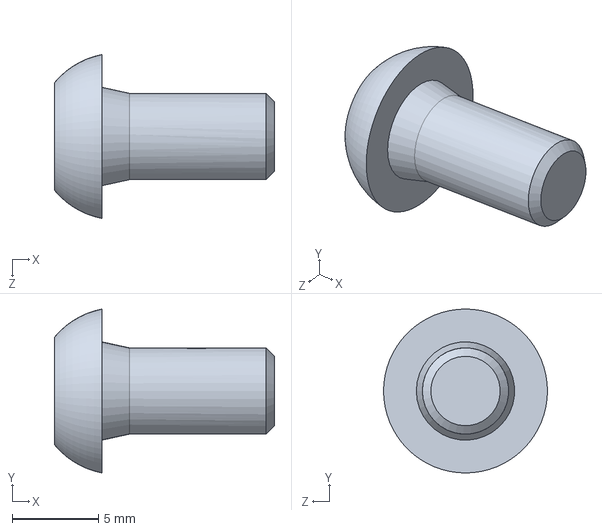
[picture p42: CAD file, 2022-11-20]
12 original part assembly and drawing/HBCBM5-10.SLDPRT
12.8 x 9.50 x 9.50 mm
