rocbuilder/folding-trolley/12 original part assembly and drawing/SHFBS3-10.SLDPRT

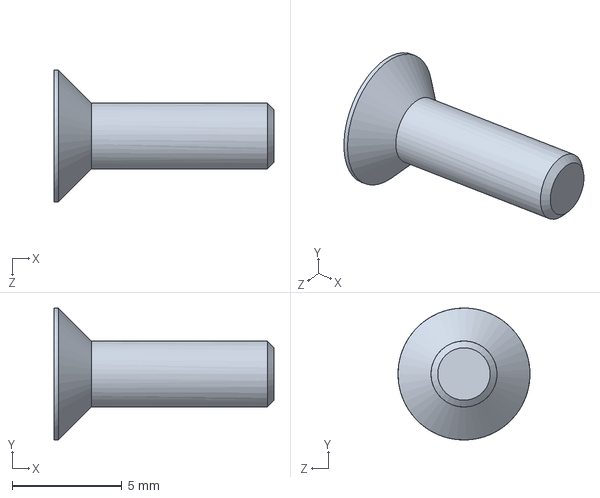
[picture p43: CAD file, 2022-11-20]
12 original part assembly and drawing/SHFBS3-10.SLDPRT
10.0 x 6.00 x 6.00 mm
