rocbuilder/folding-trolley/12 original part assembly and drawing/HNTTSN6-6.SLDPRT

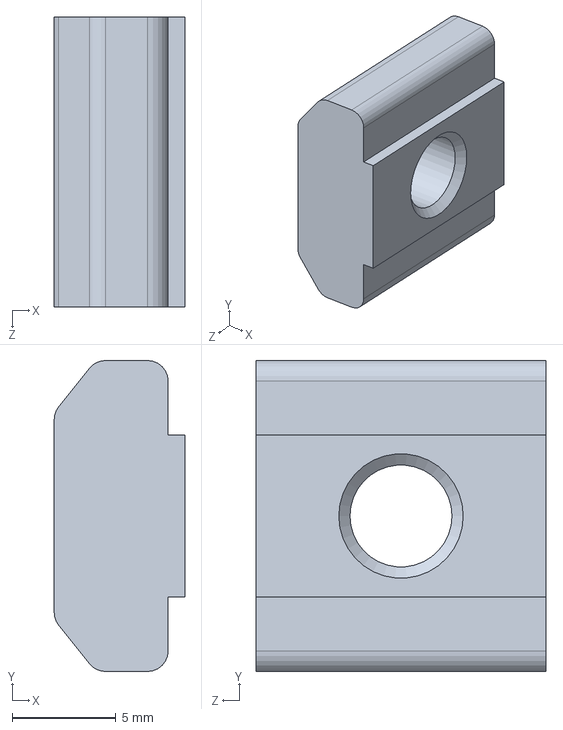
[picture p44: CAD file, 2022-11-20]
12 original part assembly and drawing/HNTTSN6-6.SLDPRT
6.30 x 15.0 x 14.0 mm
