rocbuilder/folding-trolley/12 original part assembly and drawing/SKNTR8.SLDPRT

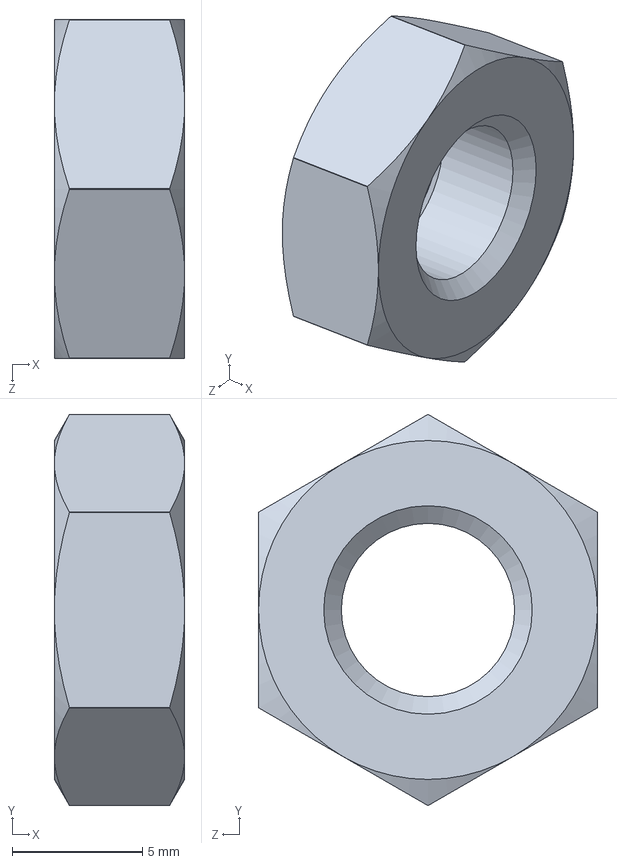
[picture p45: CAD file, 2022-11-20]
12 original part assembly and drawing/SKNTR8.SLDPRT
5.00 x 15.0 x 13.0 mm
