rocbuilder/folding-trolley/12 original part assembly and drawing/shelf top.SLDPRT

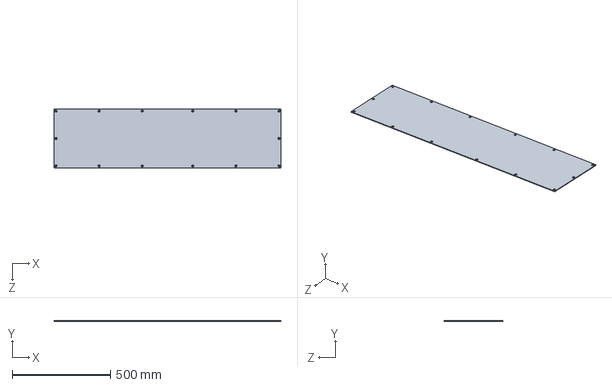
[picture p46: CAD file, 2022-11-20]
12 original part assembly and drawing/shelf top.SLDPRT
1158.0 x 3.00 x 300.0 mm
