rocbuilder/folding-trolley/12 original part assembly and drawing/SHFBS5-10.SLDPRT

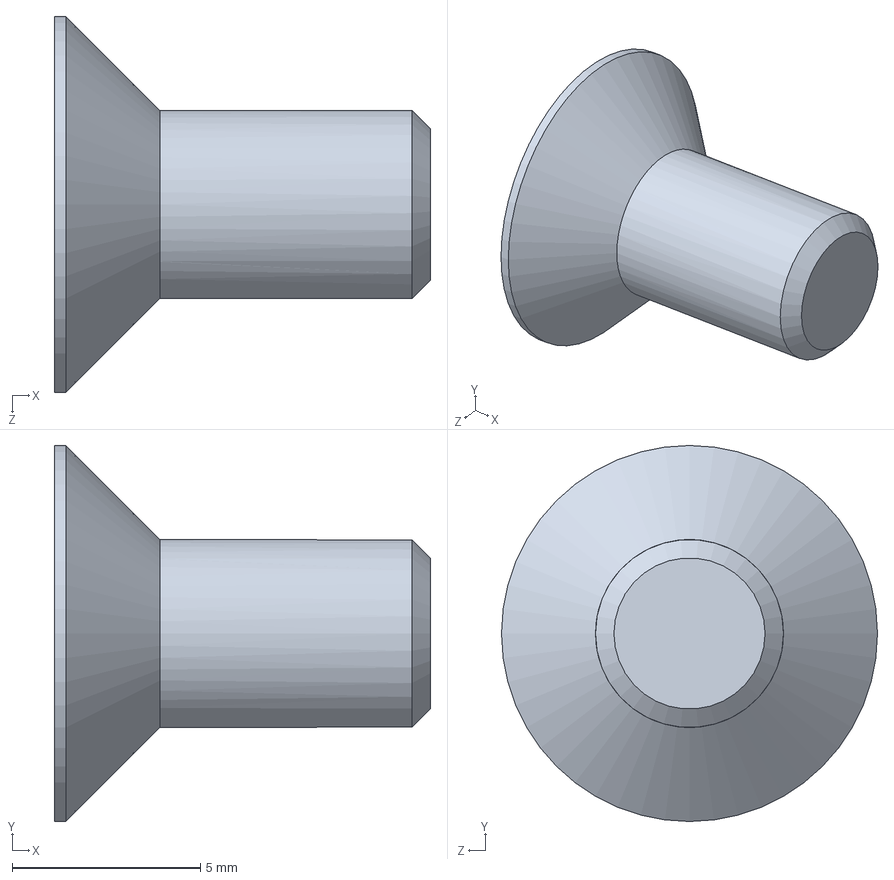
[picture p47: CAD file, 2022-11-20]
12 original part assembly and drawing/SHFBS5-10.SLDPRT
10.0 x 10.0 x 10.0 mm
