rocbuilder/folding-trolley/12 original part assembly and drawing/HFS Aluminium Frame 3030.SLDPRT

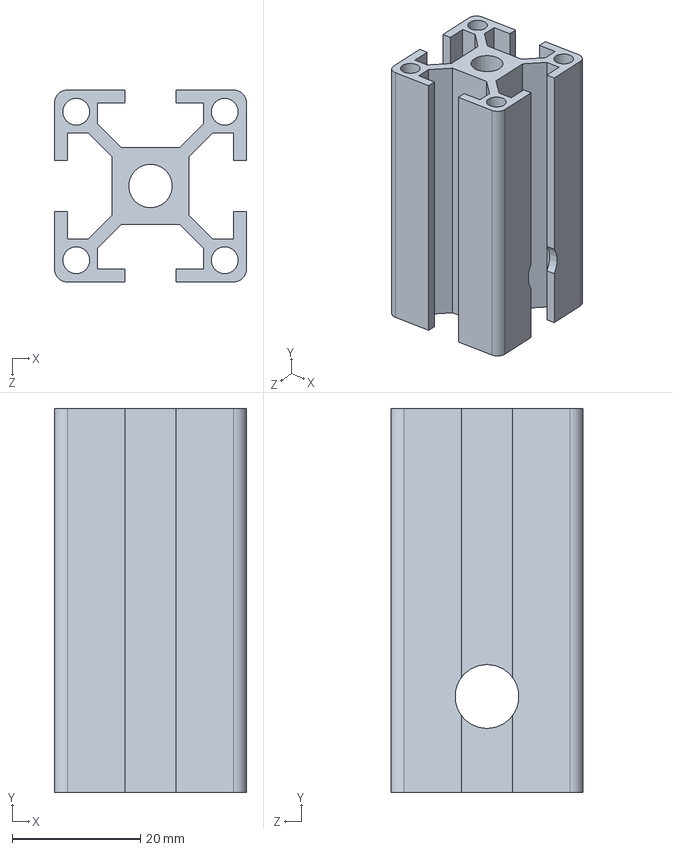
[picture p48: CAD file, 2022-11-20]
12 original part assembly and drawing/HFS Aluminium Frame 3030.SLDPRT
30.0 x 60.0 x 30.0 mm
