rocbuilder/folding-trolley/12 original part assembly and drawing/BLPS5-30.SLDPRT

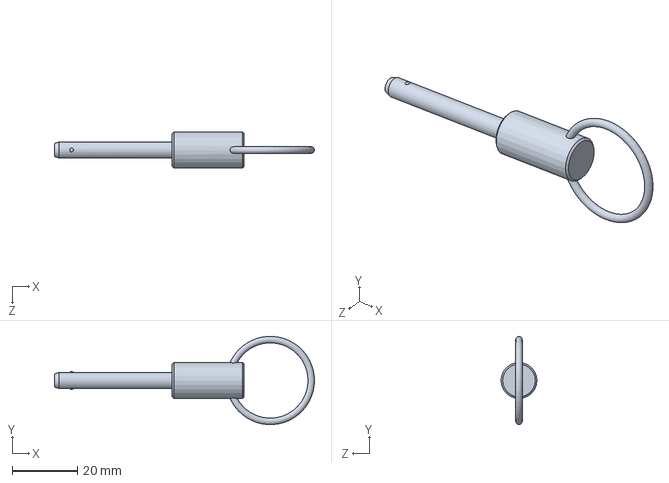
[picture p49: CAD file, 2022-11-20]
12 original part assembly and drawing/BLPS5-30.SLDPRT
79.5 x 27.0 x 11.0 mm
