rocbuilder/folding-trolley/12 original part assembly and drawing/HHPBSN5 flat 2020 hinge.SLDPRT

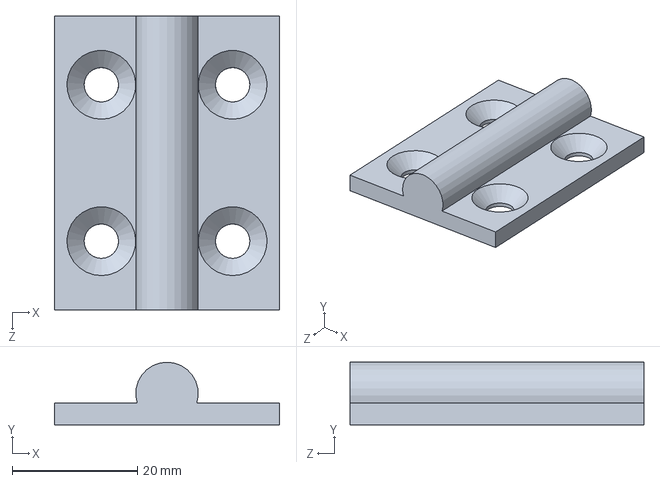
[picture p50: CAD file, 2022-11-20]
12 original part assembly and drawing/HHPBSN5 flat 2020 hinge.SLDPRT
36.0 x 10.0 x 47.0 mm
