rocbuilder/folding-trolley/12 original part assembly and drawing/lblt10 index plunger.SLDPRT

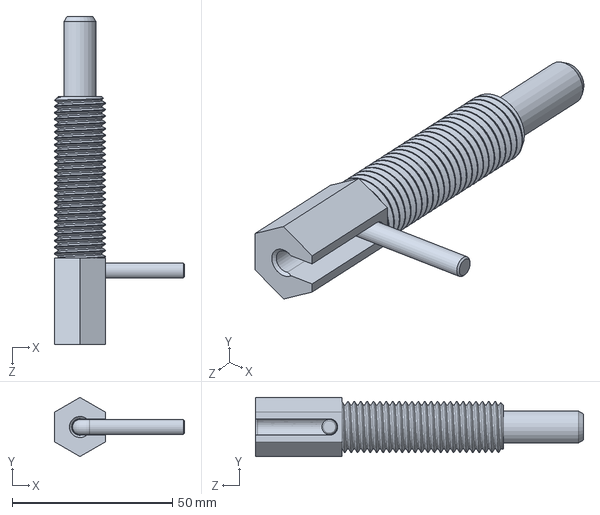
[picture p51: CAD file, 2022-11-20]
12 original part assembly and drawing/lblt10 index plunger.SLDPRT
40.7 x 18.5 x 102.5 mm
