rocbuilder/folding-trolley/12 original part assembly and drawing/convex bent sheet metal mounting plate.SLDPRT

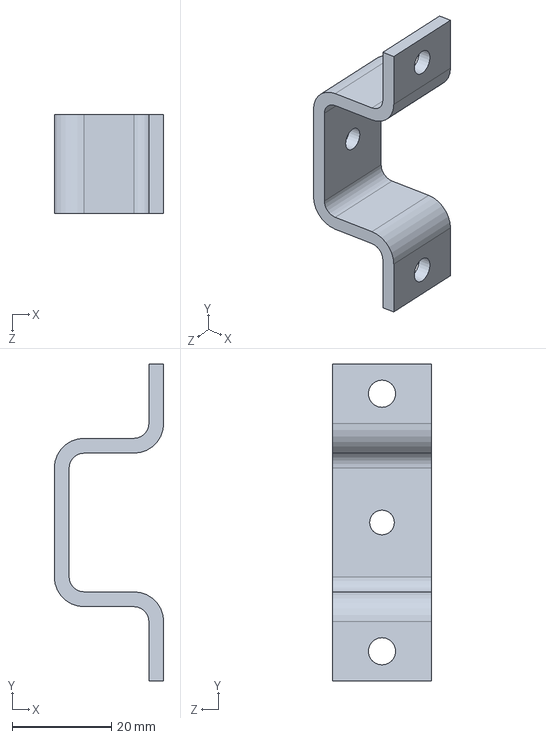
[picture p52: CAD file, 2022-11-20]
12 original part assembly and drawing/convex bent sheet metal mounting plate.SLDPRT
22.1 x 64.0 x 20.0 mm
