rocbuilder/folding-trolley/12 original part assembly and drawing/caster frame interface.SLDPRT

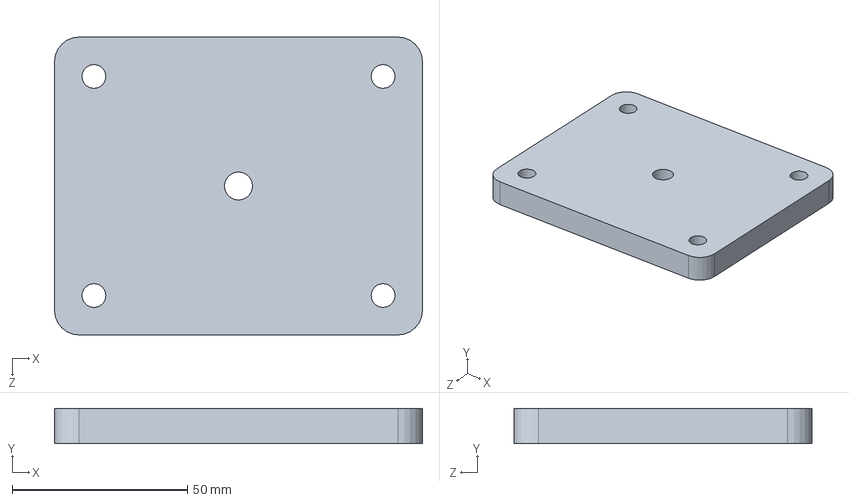
[picture p53: CAD file, 2022-11-20]
12 original part assembly and drawing/caster frame interface.SLDPRT
105.0 x 10.0 x 85.0 mm
