rocbuilder/folding-trolley/12 original part assembly and drawing/SHFBS3-8.SLDPRT

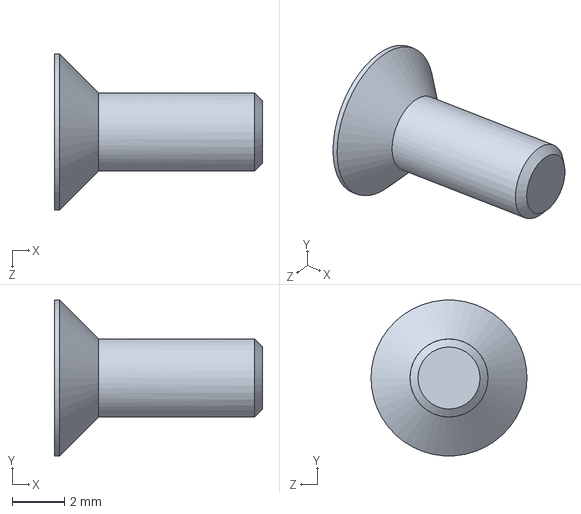
[picture p54: CAD file, 2022-11-20]
12 original part assembly and drawing/SHFBS3-8.SLDPRT
8.00 x 5.99 x 6.00 mm
