rocbuilder/folding-trolley/12 original part assembly and drawing/SPWF5.SLDPRT

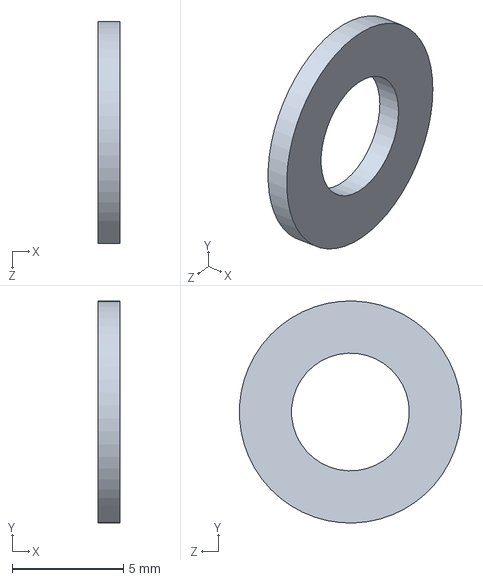
[picture p55: CAD file, 2022-11-20]
12 original part assembly and drawing/SPWF5.SLDPRT
1.00 x 10.00 x 9.99 mm
