rocbuilder/folding-trolley/12 original part assembly and drawing/shelf support bracket.SLDPRT

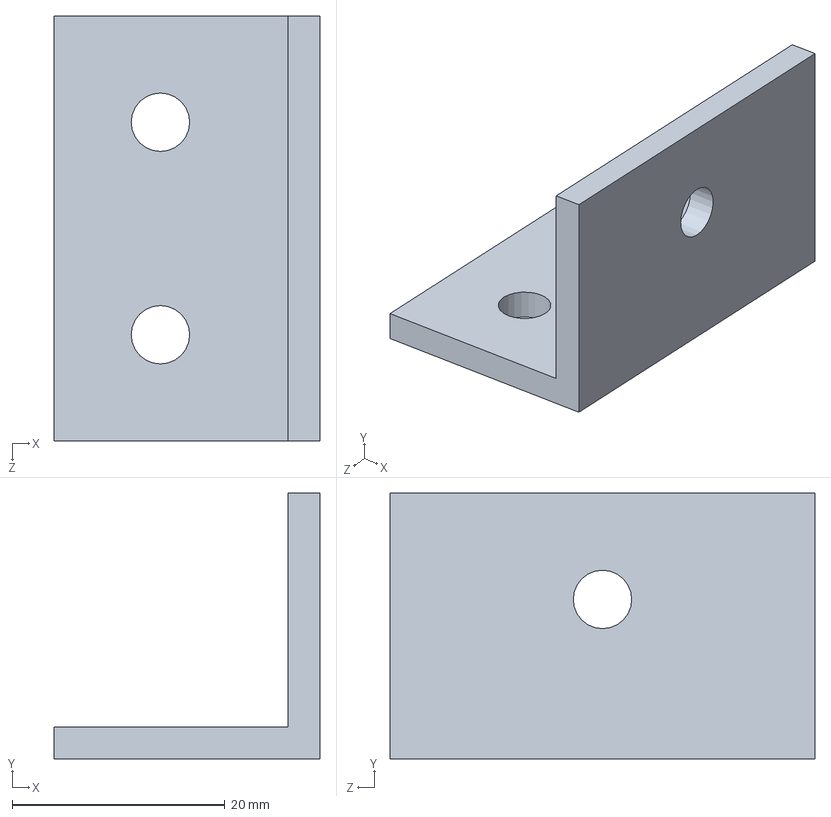
[picture p56: CAD file, 2022-11-20]
12 original part assembly and drawing/shelf support bracket.SLDPRT
25.0 x 25.0 x 40.0 mm
