rocbuilder/folding-trolley/12 original part assembly and drawing/lblt6.SLDPRT

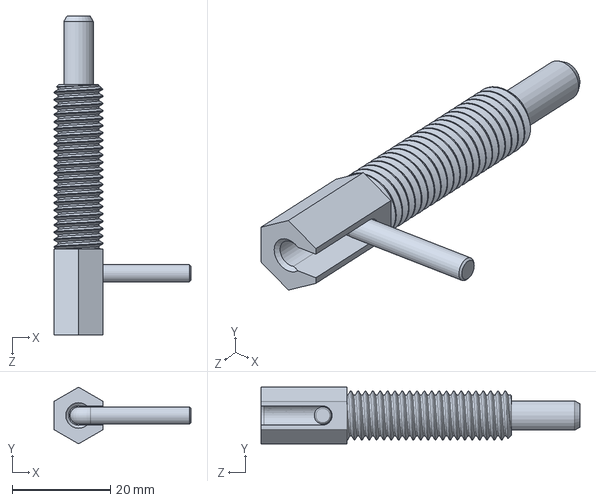
[picture p57: CAD file, 2022-11-20]
12 original part assembly and drawing/lblt6.SLDPRT
27.9 x 11.5 x 65.0 mm
