rocbuilder/folding-trolley/12 original part assembly and drawing/SKNTR3.SLDPRT

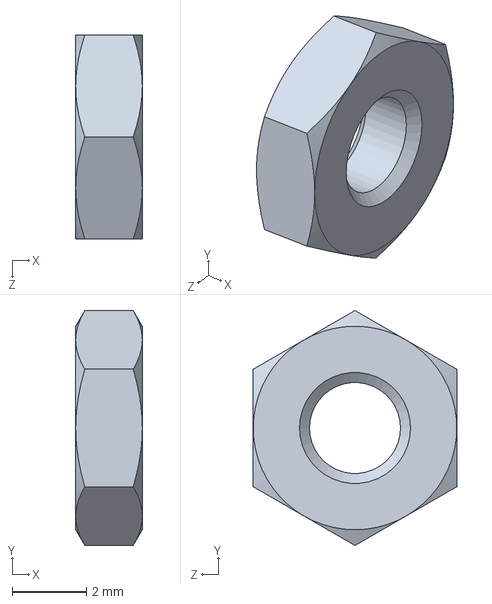
[picture p58: CAD file, 2022-11-20]
12 original part assembly and drawing/SKNTR3.SLDPRT
1.80 x 6.35 x 5.50 mm
