rocbuilder/folding-trolley/12 original part assembly and drawing/BCS-06-14 standin.SLDPRT

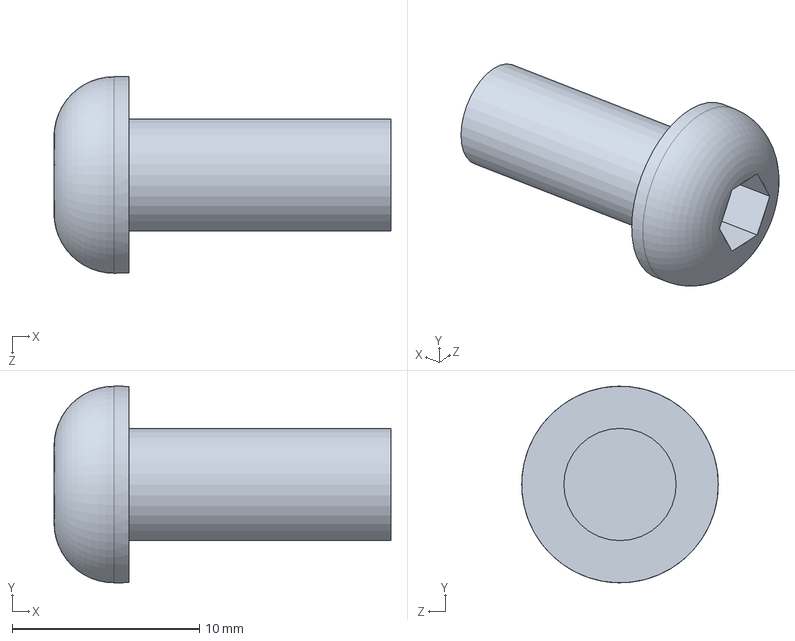
[picture p59: CAD file, 2022-11-20]
12 original part assembly and drawing/BCS-06-14 standin.SLDPRT
18.0 x 10.5 x 10.5 mm
