rocbuilder/folding-trolley/12 original part assembly and drawing/SCB5-10.SLDPRT

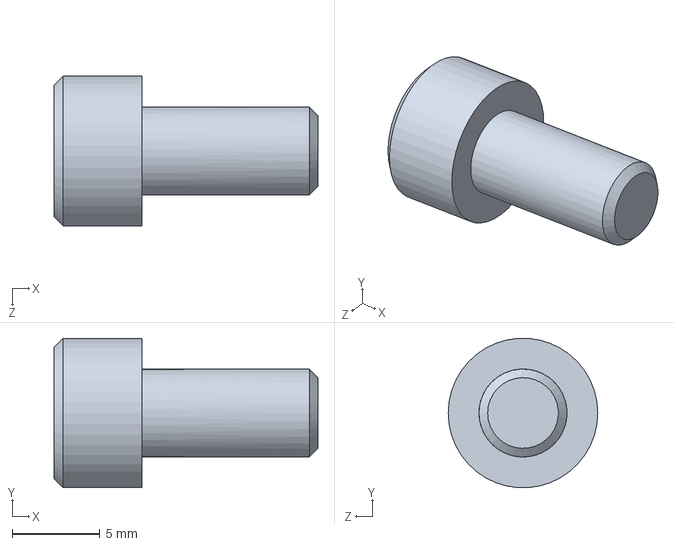
[picture p60: CAD file, 2022-11-20]
12 original part assembly and drawing/SCB5-10.SLDPRT
15.0 x 8.48 x 8.50 mm
