rocbuilder/folding-trolley/12 original part assembly and drawing/SCB6-40.SLDPRT

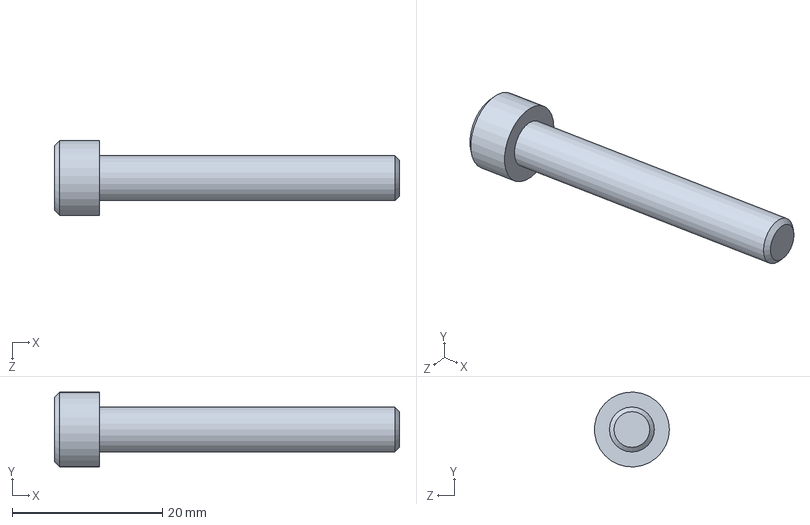
[picture p61: CAD file, 2022-11-20]
12 original part assembly and drawing/SCB6-40.SLDPRT
46.0 x 9.99 x 9.97 mm
