rocbuilder/folding-trolley/12 original part assembly and drawing/SCB5-40.SLDPRT

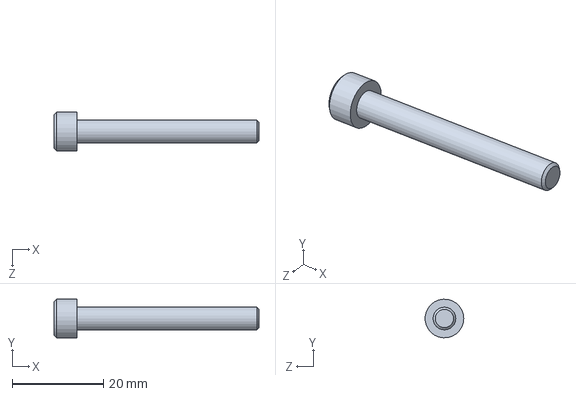
[picture p62: CAD file, 2022-11-20]
12 original part assembly and drawing/SCB5-40.SLDPRT
45.0 x 8.49 x 8.47 mm
