rocbuilder/folding-trolley/12 original part assembly and drawing/SPWF6.SLDPRT

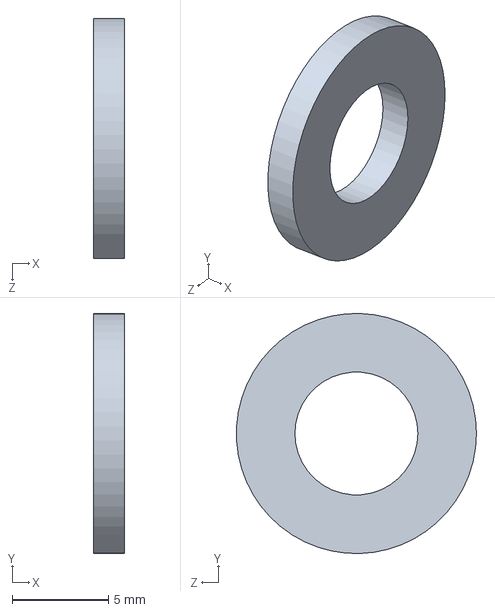
[picture p63: CAD file, 2022-11-20]
12 original part assembly and drawing/SPWF6.SLDPRT
1.60 x 12.5 x 12.5 mm
