rocbuilder/folding-trolley/12 original part assembly and drawing/BLPS6-30.SLDPRT

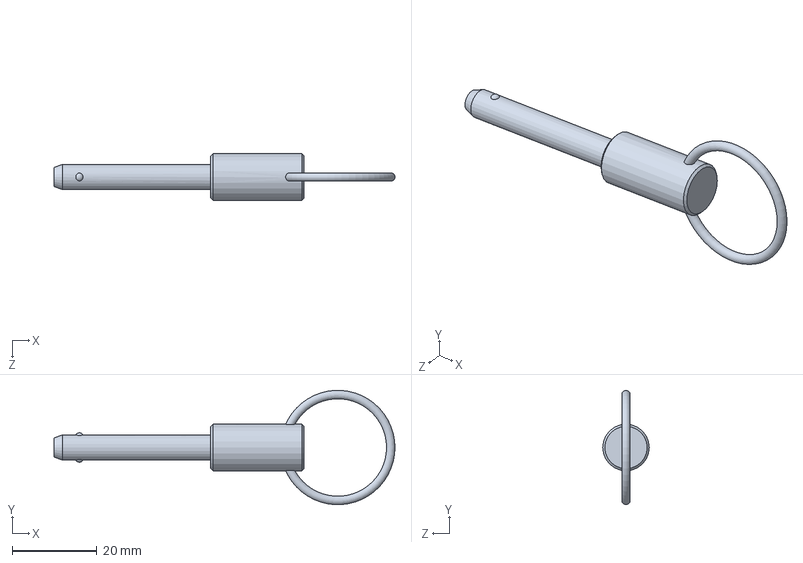
[picture p64: CAD file, 2022-11-20]
12 original part assembly and drawing/BLPS6-30.SLDPRT
80.5 x 27.0 x 11.0 mm
