rocbuilder/folding-trolley/12 original part assembly and drawing/IBNP4-8.SLDPRT

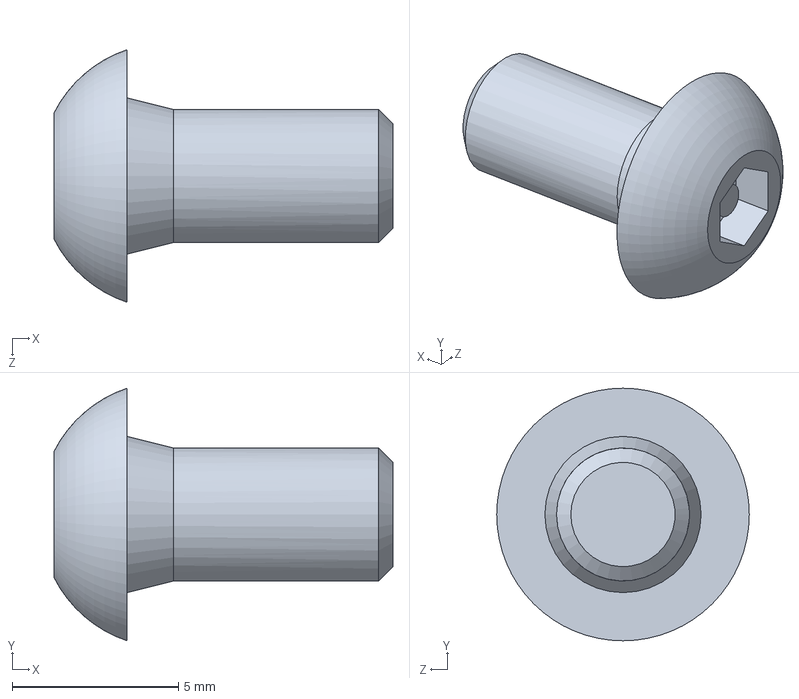
[picture p65: CAD file, 2022-11-20]
12 original part assembly and drawing/IBNP4-8.SLDPRT
10.2 x 7.60 x 7.60 mm
