rocbuilder/folding-trolley/(list of files, cad)

Other CAD files:
12 original part assembly and drawing/bottom plate.SLDPRT
12 original part assembly and drawing/_STOPPER-HSMCS50.SLDPRT
12 original part assembly and drawing/index plate.SLDPRT
12 original part assembly and drawing/ars20d-300_03.SLDPRT
12 original part assembly and drawing/top plate.SLDPRT
12 original part assembly and drawing/_FBL27D+200 Retainer.SLDPRT
12 original part assembly and drawing/toggle clamp bracket.SLDPRT
12 original part assembly and drawing/_DUMMY-HSMCS50-N.SLDPRT
12 original part assembly and drawing/_BODY-HSMCS50.SLDPRT
12 original part assembly and drawing/ars20d-300_02.SLDPRT
12 original part assembly and drawing/_C-CTCS125-R_b.SLDPRT
12 original part assembly and drawing/SBCB5-10.SLDPRT
12 original part assembly and drawing/_FBL27D+200 Center Rail.SLDPRT
12 original part assembly and drawing/vertical plate.SLDPRT
12 original part assembly and drawing/testpartno.SLDPRT
12 original part assembly and drawing/SCB6-451.SLDPRT
12 original part assembly and drawing/_WHEEL-HSMCS50-N.SLDPRT
12 original part assembly and drawing/_C-CTCS125-R_m.SLDPRT
12 original part assembly and drawing/Spindel.SLDPRT
12 original part assembly and drawing/indexer plate.SLDPRT
12 original part assembly and drawing/_FBL27D+200 Drawer rail.SLDPRT
12 original part assembly and drawing/_SWIVEL-HSMCS50.SLDPRT
12 original part assembly and drawing/_C-CTCS125-R_w.SLDPRT
12 full assembly.x_t
12 original part assembly and drawing/HFS Aluminium Frame 2020 frame horizontal.SLDDRW
12 original part assembly and drawing/HNTTSN5-5 2020 nut.SLDPRT
12 original part assembly and drawing/SFB8-20 flat head screw.SLDPRT
12 original part assembly and drawing/SLBNR16 M16 nut.SLDPRT
12 original part assembly and drawing/SSLW8 spring washer.SLDPRT
12 original part assembly and drawing/folding trolley1.1.SLDDRW
12 original part assembly and drawing/folding trolley2.1.10.SLDDRW
12 original part assembly and drawing/folding trolley2.1.3.SLDDRW
12 original part assembly and drawing/folding trolley2.1.8.SLDDRW
12 original part assembly and drawing/folding trolley2.1.9.SLDDRW
12 original part assembly and drawing/folding trolley2.1.SLDDRW
12 original part assembly and drawing/frame assembly.SLDDRW
12 original part assembly and drawing/shelf assembly.SLDDRW
